drewsum/LTC7851_Demo/hdw/LTC7851_Demo/render1.png

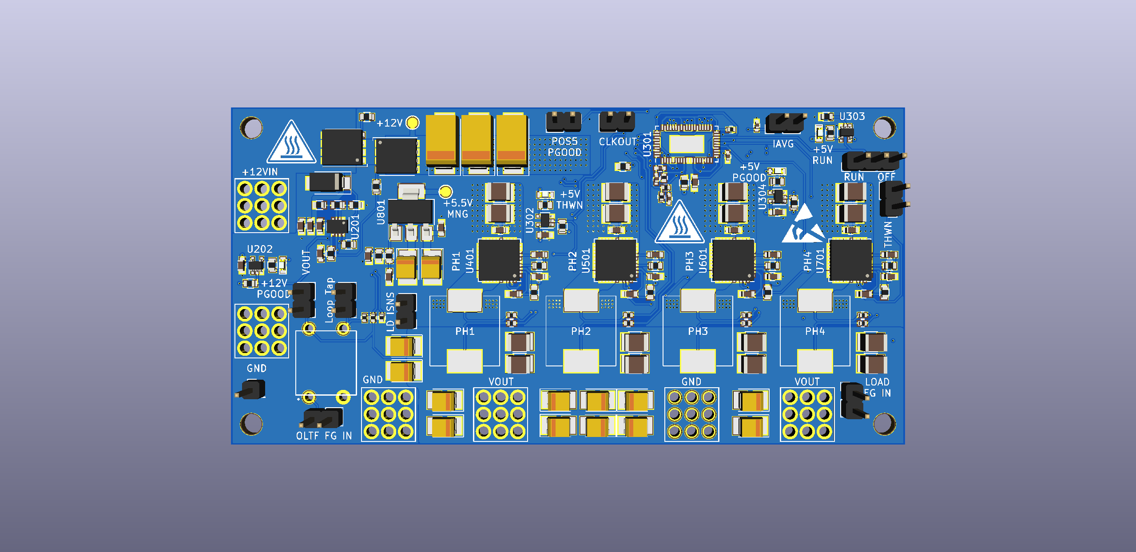
hdw/LTC7851_Demo/render1.png
