drewsum/LTC7851_Demo/hdw/LTC7851_Demo/render2.png

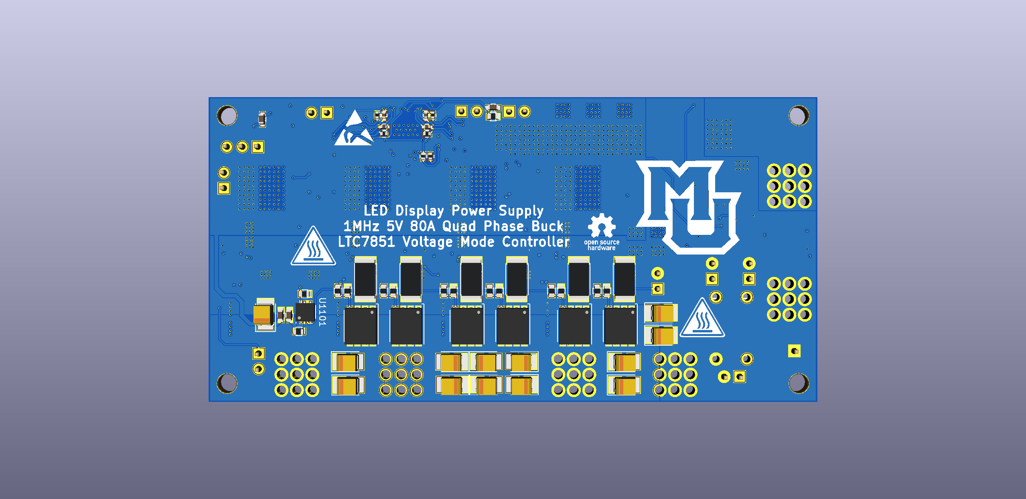
hdw/LTC7851_Demo/render2.png
