drewsum/LTC7851_Demo/README.md

# LTC7851_Demo
Demo board for testing LTC7851 Quad Phase Buck Converter
KiCAD V5.0.0
