drewsum/LTC7851_Demo/hdw/LTC7851_Demo/LTC7851_Demo.pdf

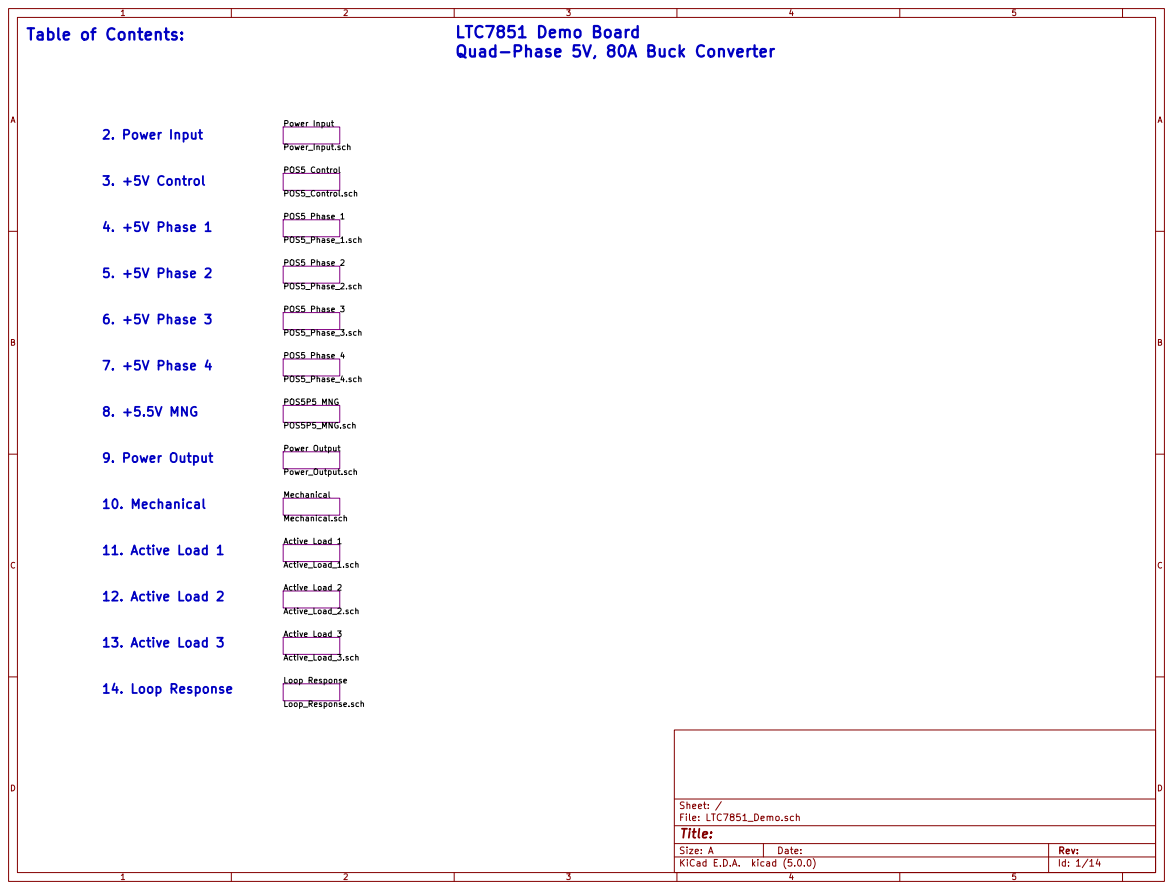
[picture p3: page 1]

Power_Input.sch POS5 Control POS5_Control.sch POS5 Phase 1 POS5_Phase_1.sch POS5 Phase 2 POS5_Phase_2.sch POS5 Phase 3 POS5_Phase_3.sch POS5 Phase 4 POS5_Phase_4.sch POS5P5 MNG

Quad-Phase 5V, 80A Buck Converter

7. +5V Phase 4
Power_Output.sch Mechanical Mechanical.sch Active Load 1 Active_Load_1.sch Active Load 2 Active_Load_2.sch Active Load 3 Active_Load_3.sch

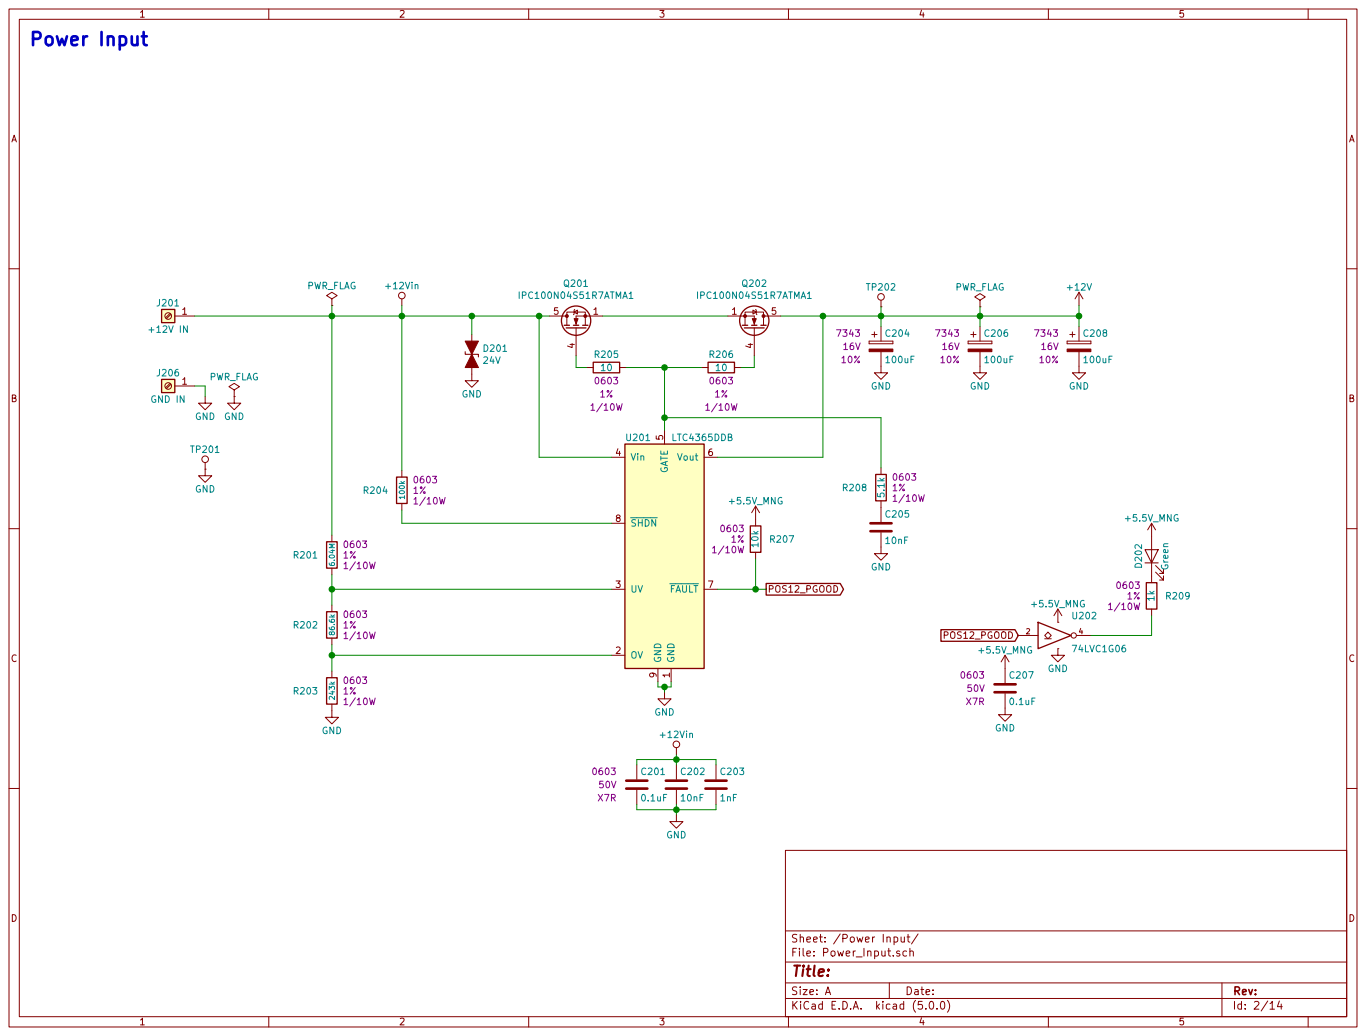
[picture p4: page 2]

5 Vout 6 FAULT 7 SHDN 8 GND

1 OV 2 UV 3 Vin 4 GATE

Sheet: /Power Input/ GND

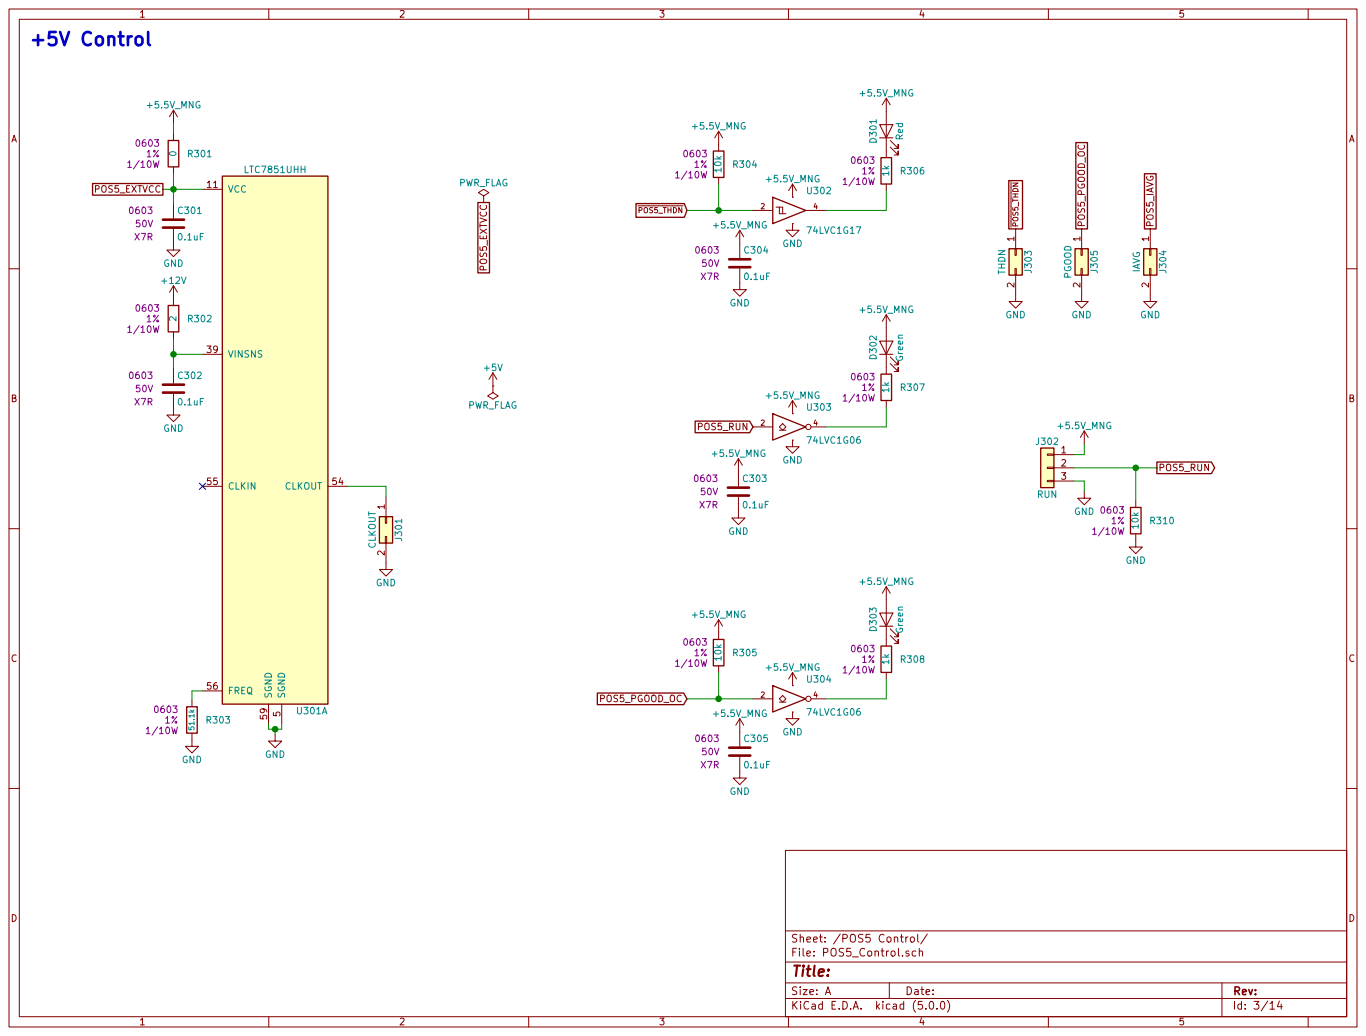
[picture p5: page 3]

5 CLKOUT 54 CLKIN 55 FREQ 56 SGND 59U301A

File: POS5_Control.sch Sheet: /POS5 Control/

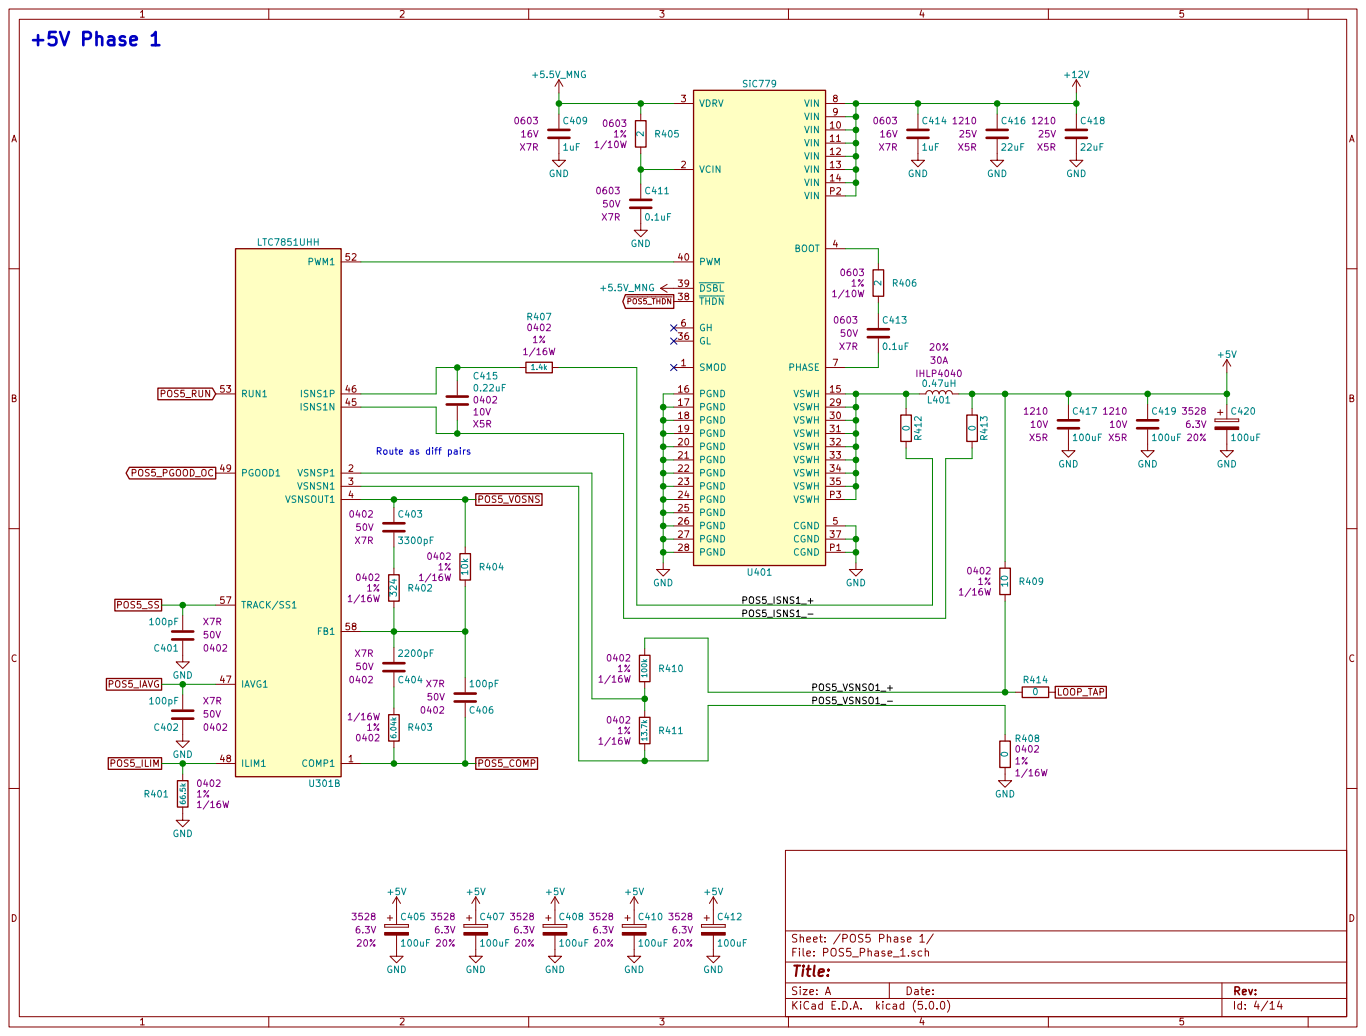
[picture p6: page 4]

POS5_ISNS1_+ POS5_ISNS1_- POS5_VSNSO1_- Route as diff pairs

File: POS5_Phase_1.sch Sheet: /POS5 Phase 1/

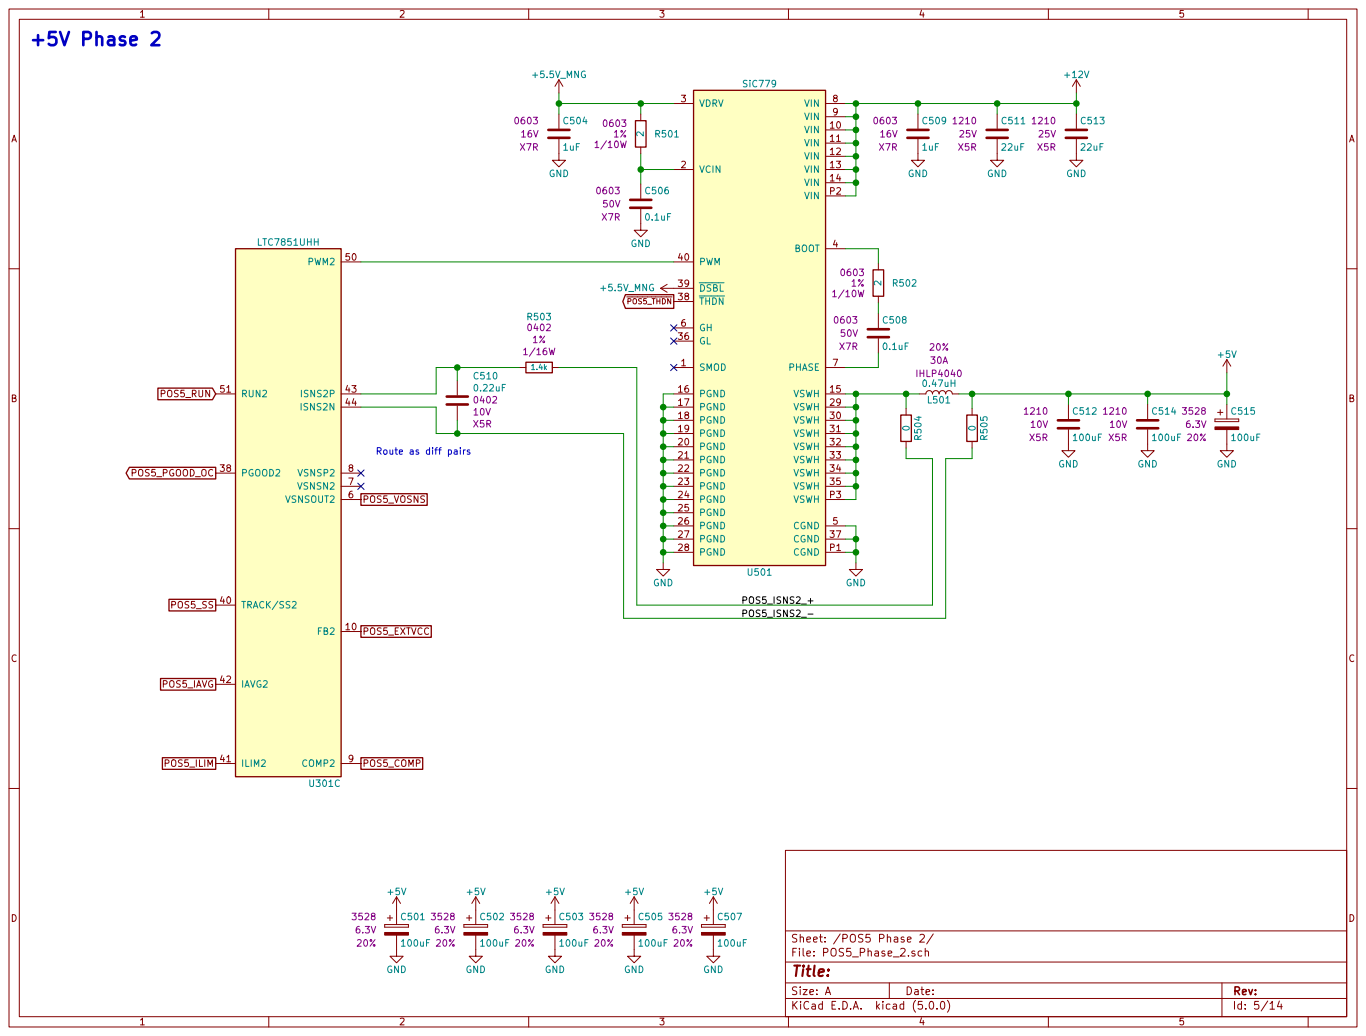
[picture p7: page 5]

File: POS5_Phase_2.sch Sheet: /POS5 Phase 2/

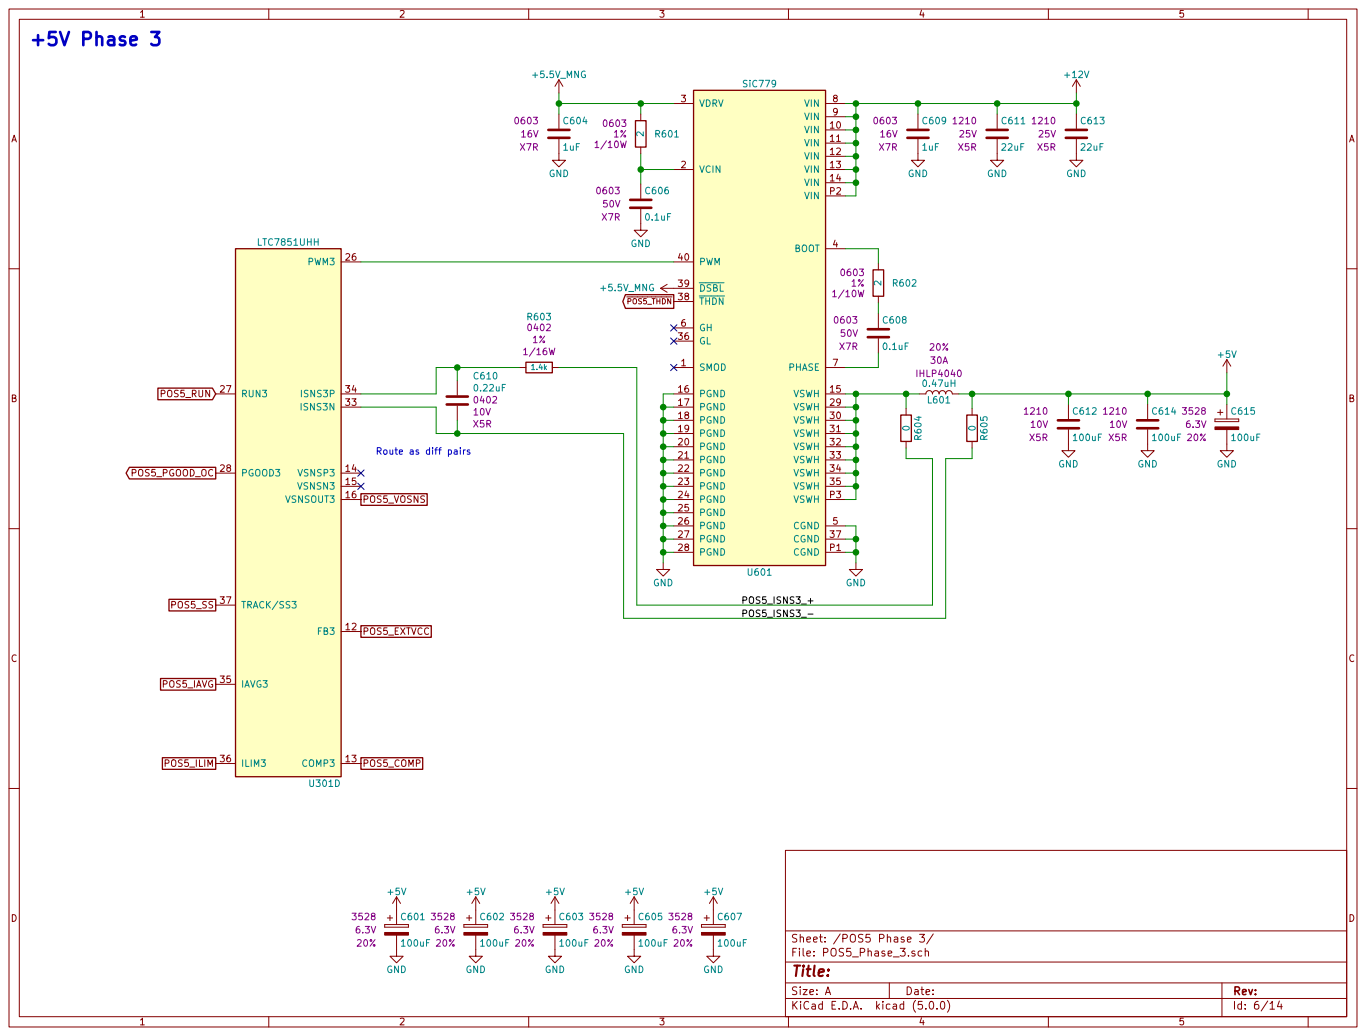
[picture p8: page 6]

File: POS5_Phase_3.sch Sheet: /POS5 Phase 3/

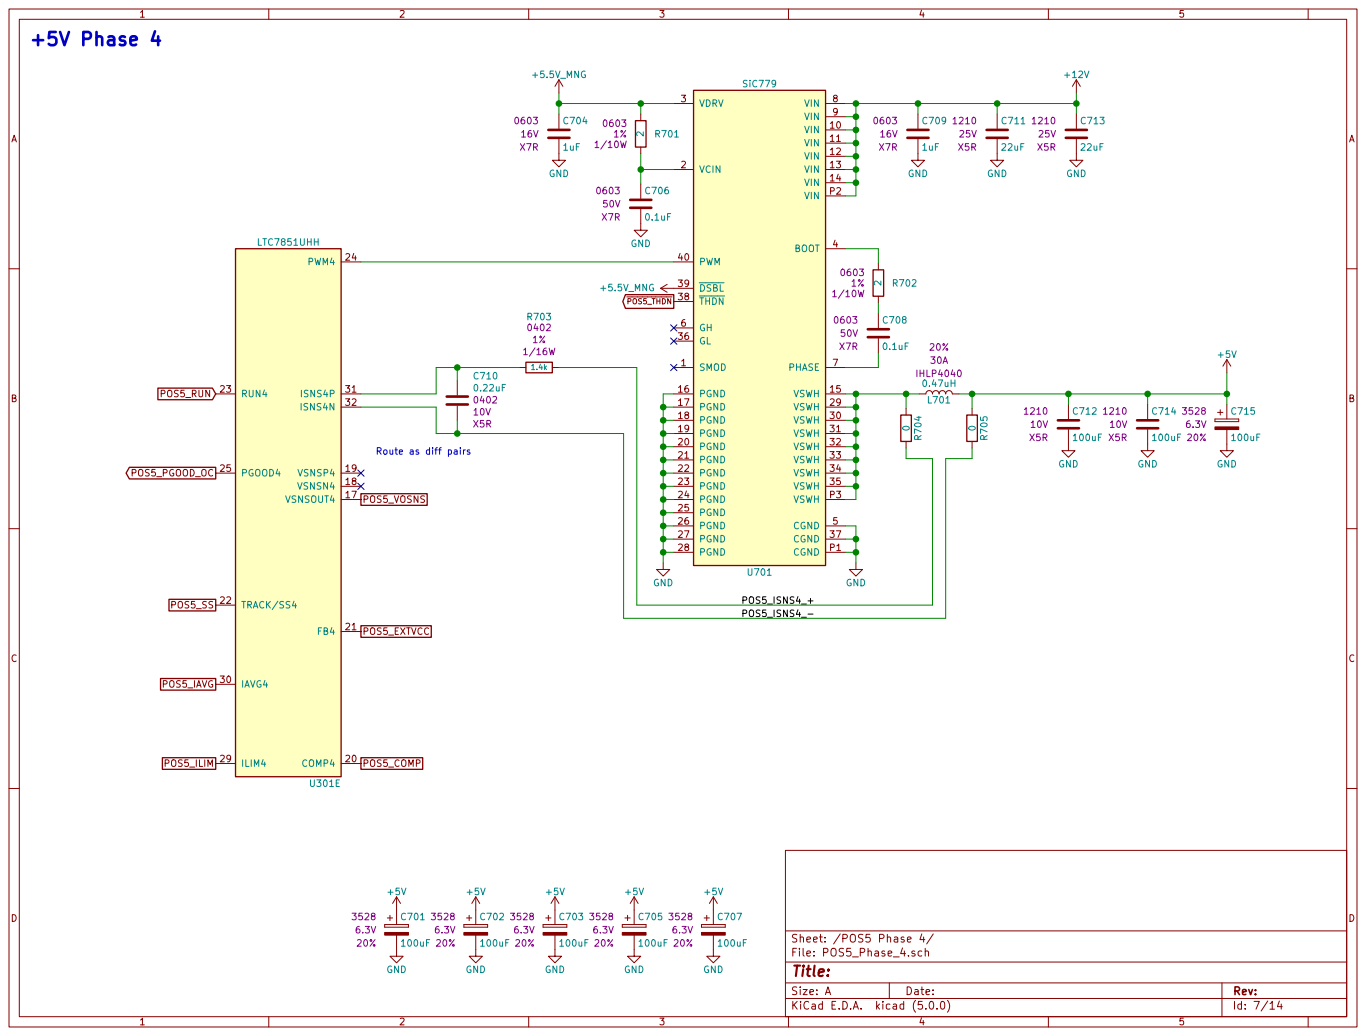
[picture p9: page 7]

File: POS5_Phase_4.sch Sheet: /POS5 Phase 4/

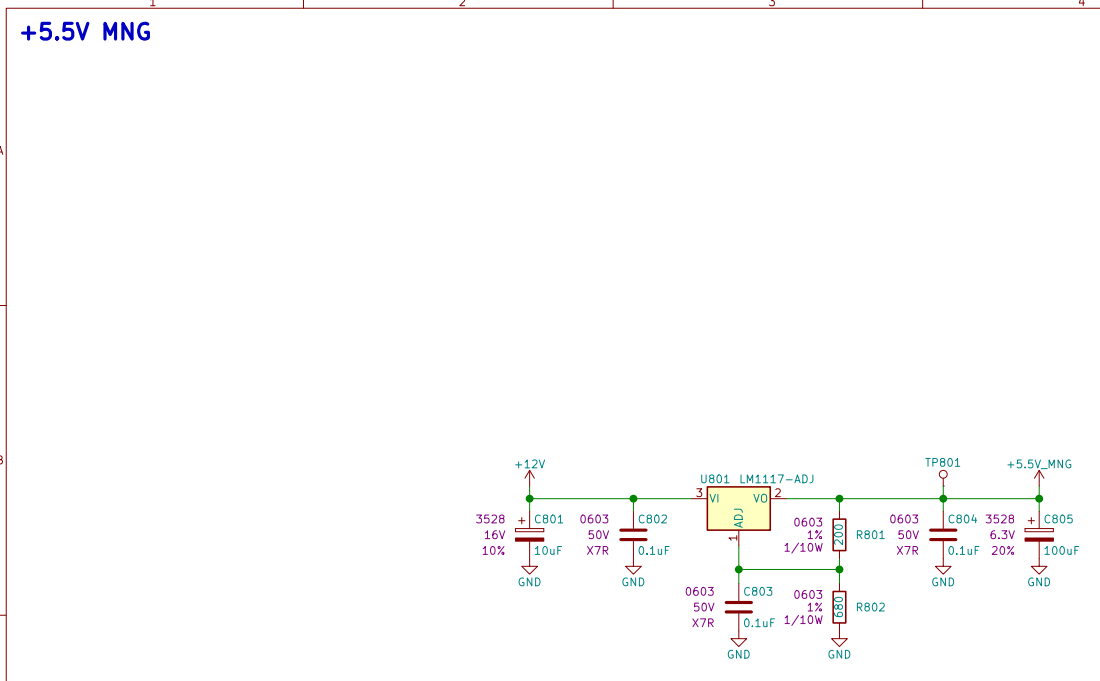
[picture p10: page 8]

File: POS5P5_MNG.sch Sheet: /POS5P5 MNG/

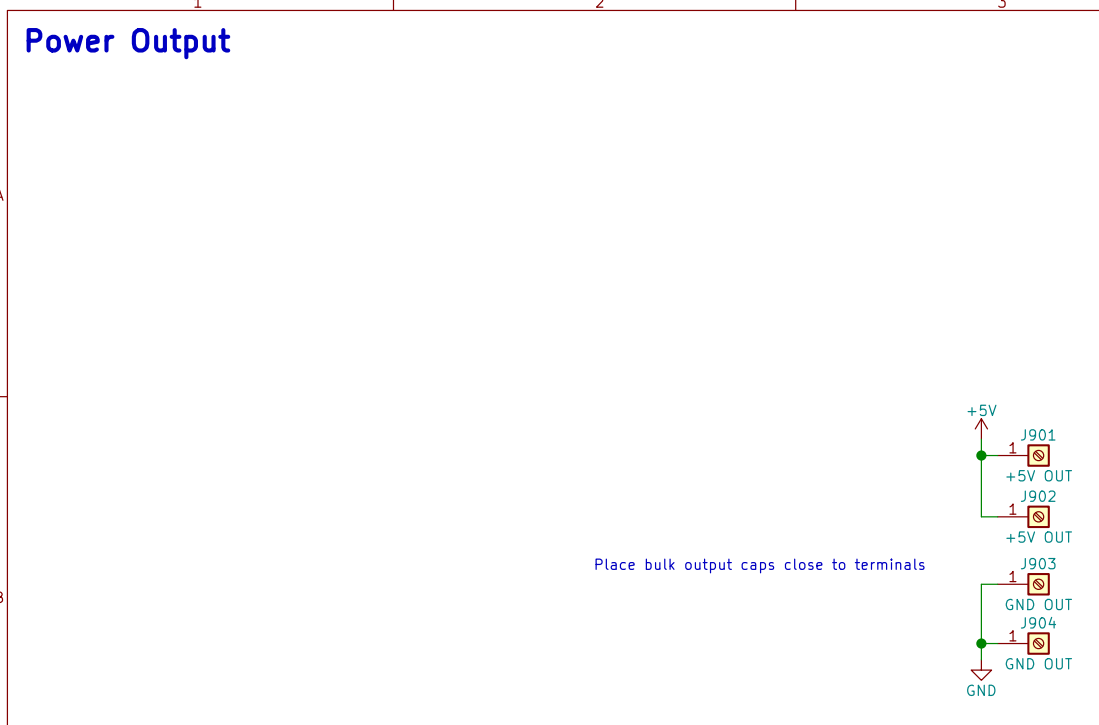
[picture p11: page 9]

Place bulk output caps close to terminals

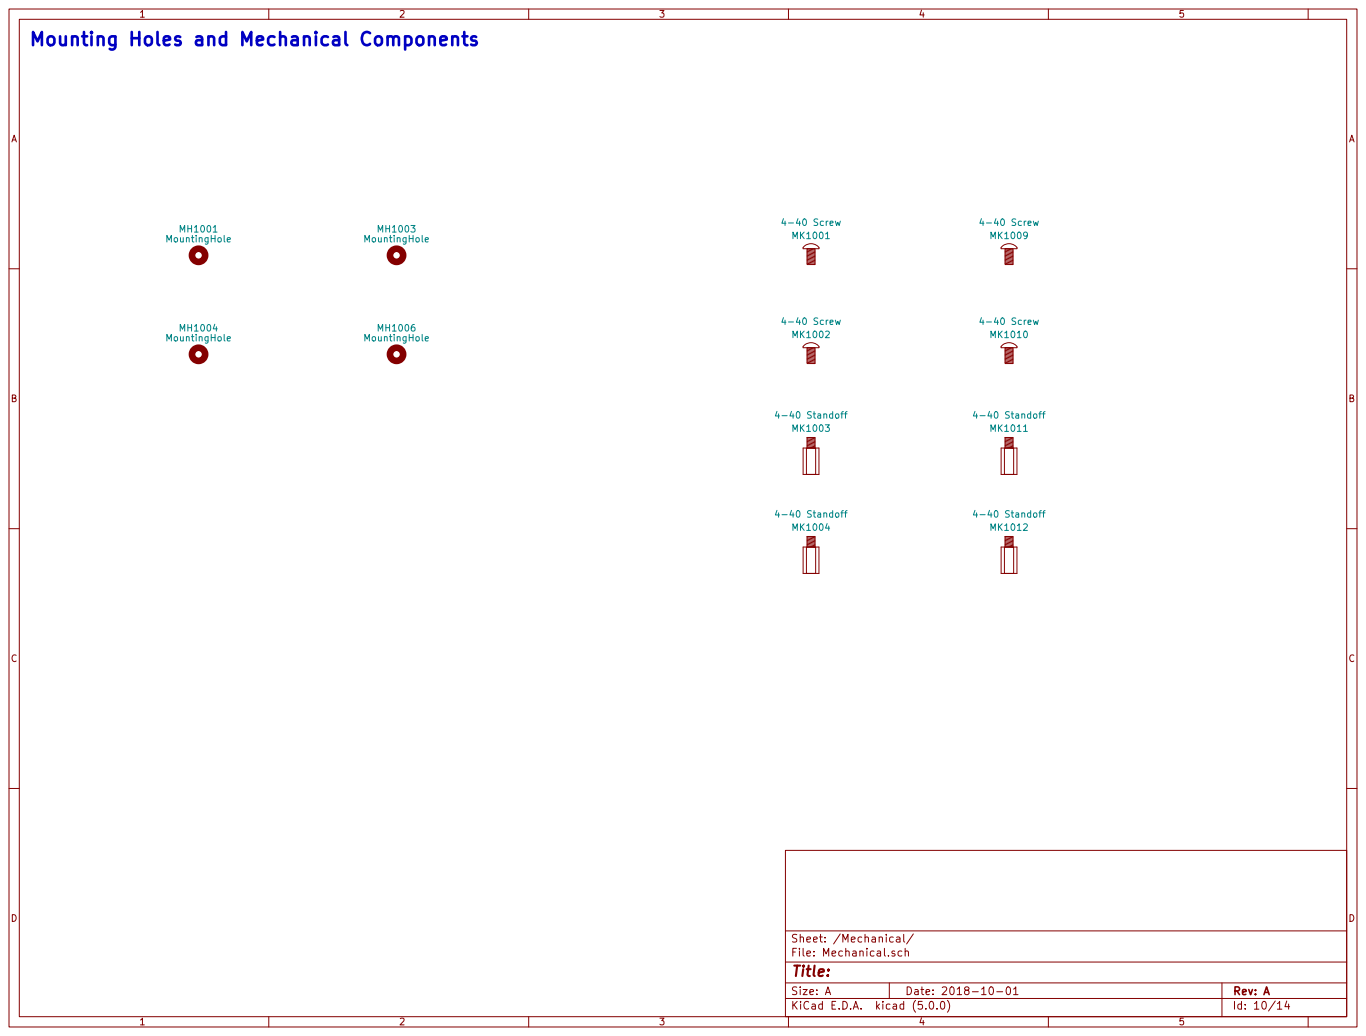
[picture p12: page 10]

Id: 10/14 Title: File: Mechanical.sch Sheet: /Mechanical/ Mounting Holes and Mechanical Components

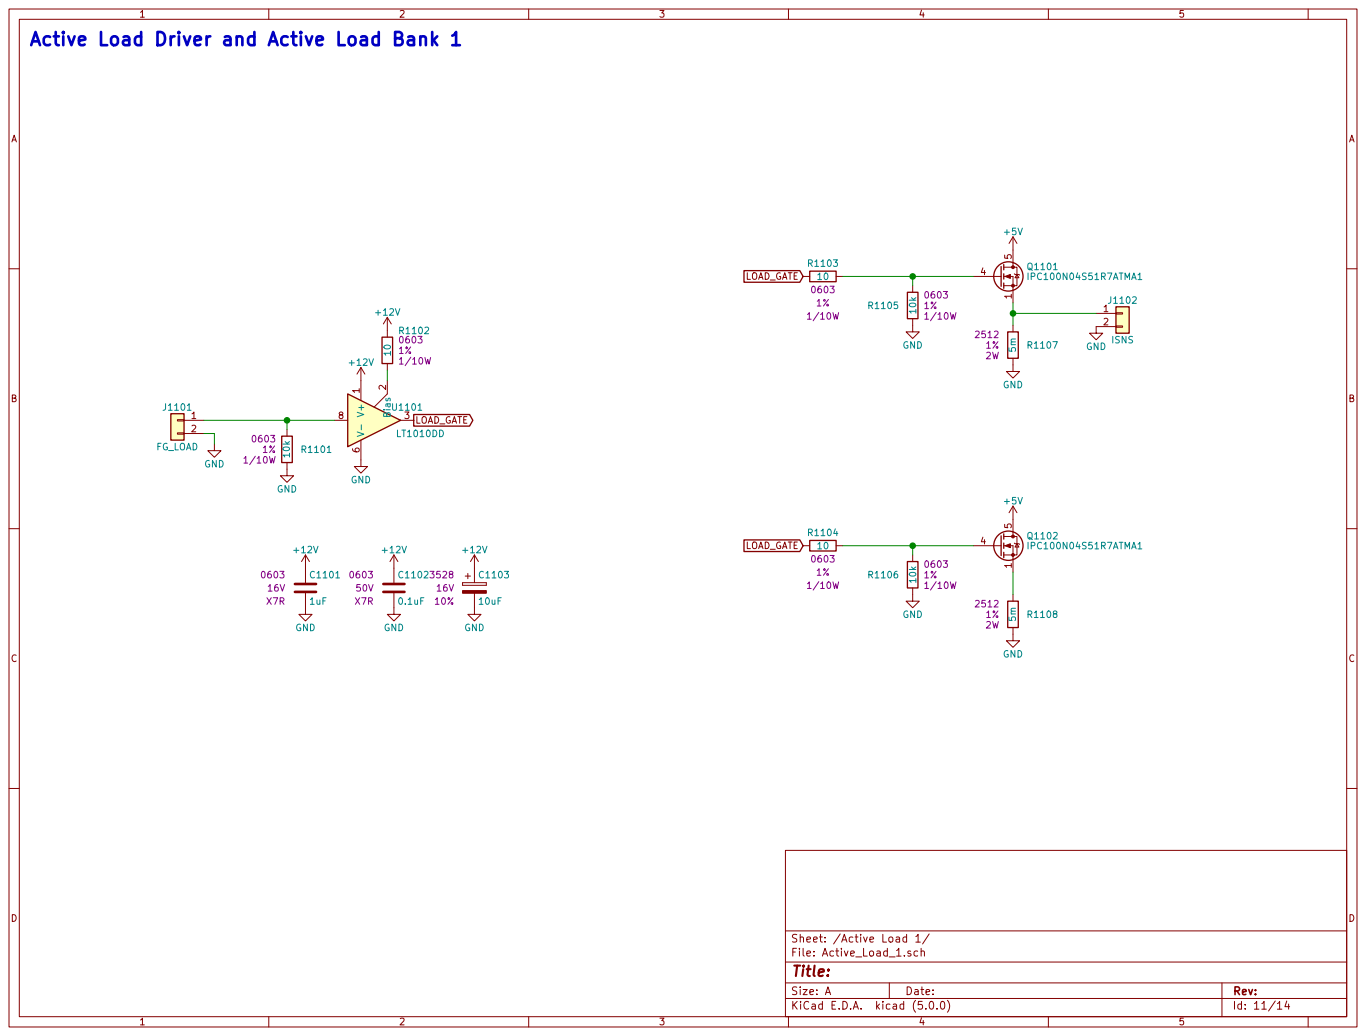
[picture p13: page 11]

+12V GND Active Load Driver and Active Load Bank 1

File: Active_Load_1.sch Sheet: /Active Load 1/

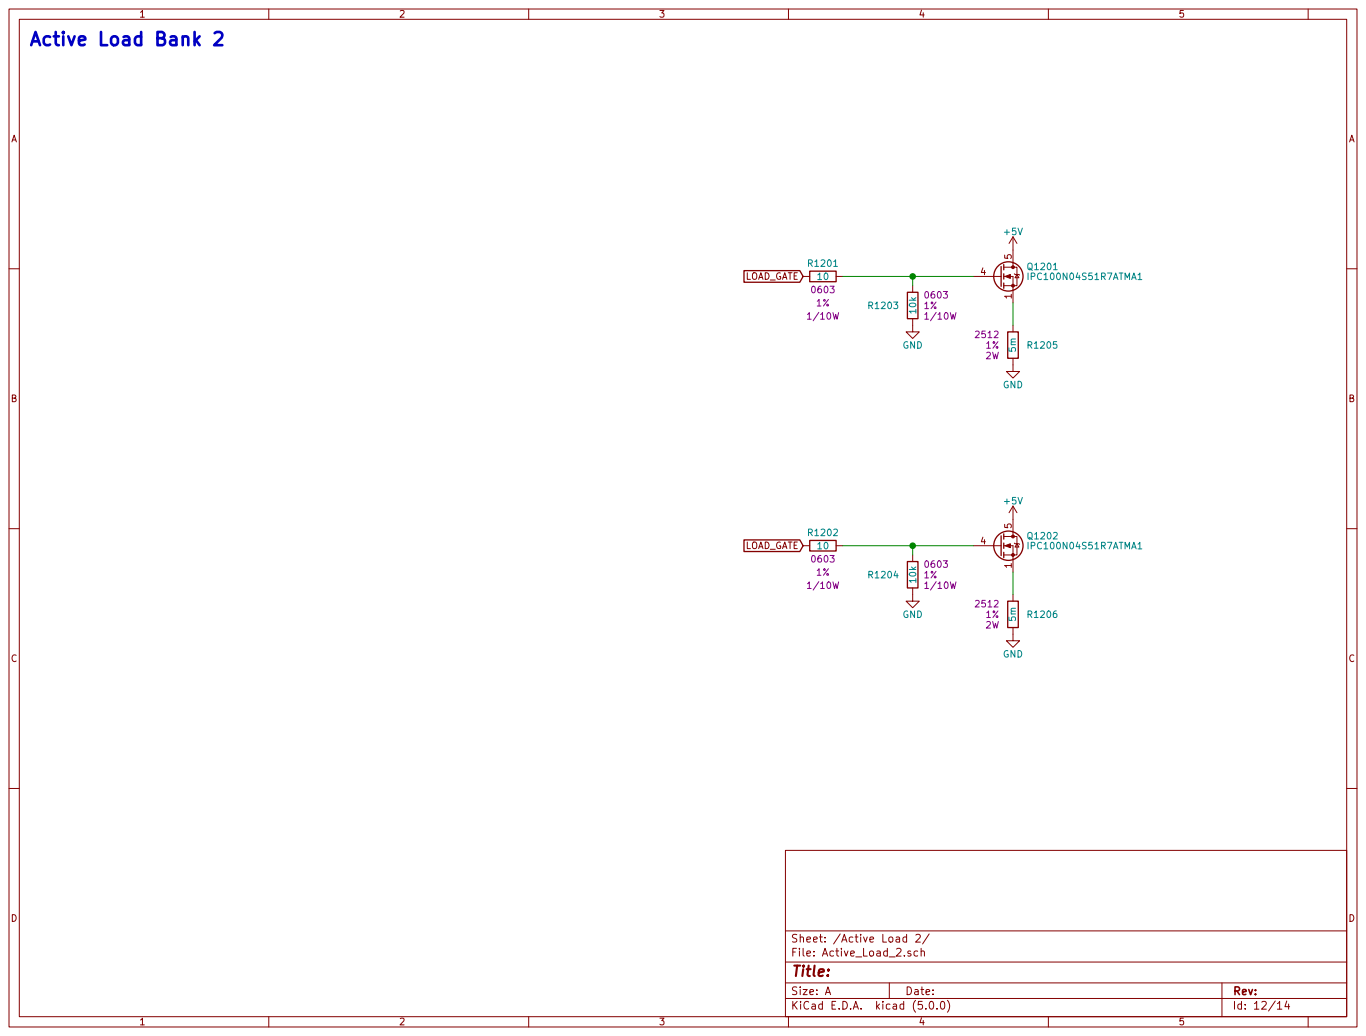
[picture p14: page 12]

File: Active_Load_2.sch Sheet: /Active Load 2/

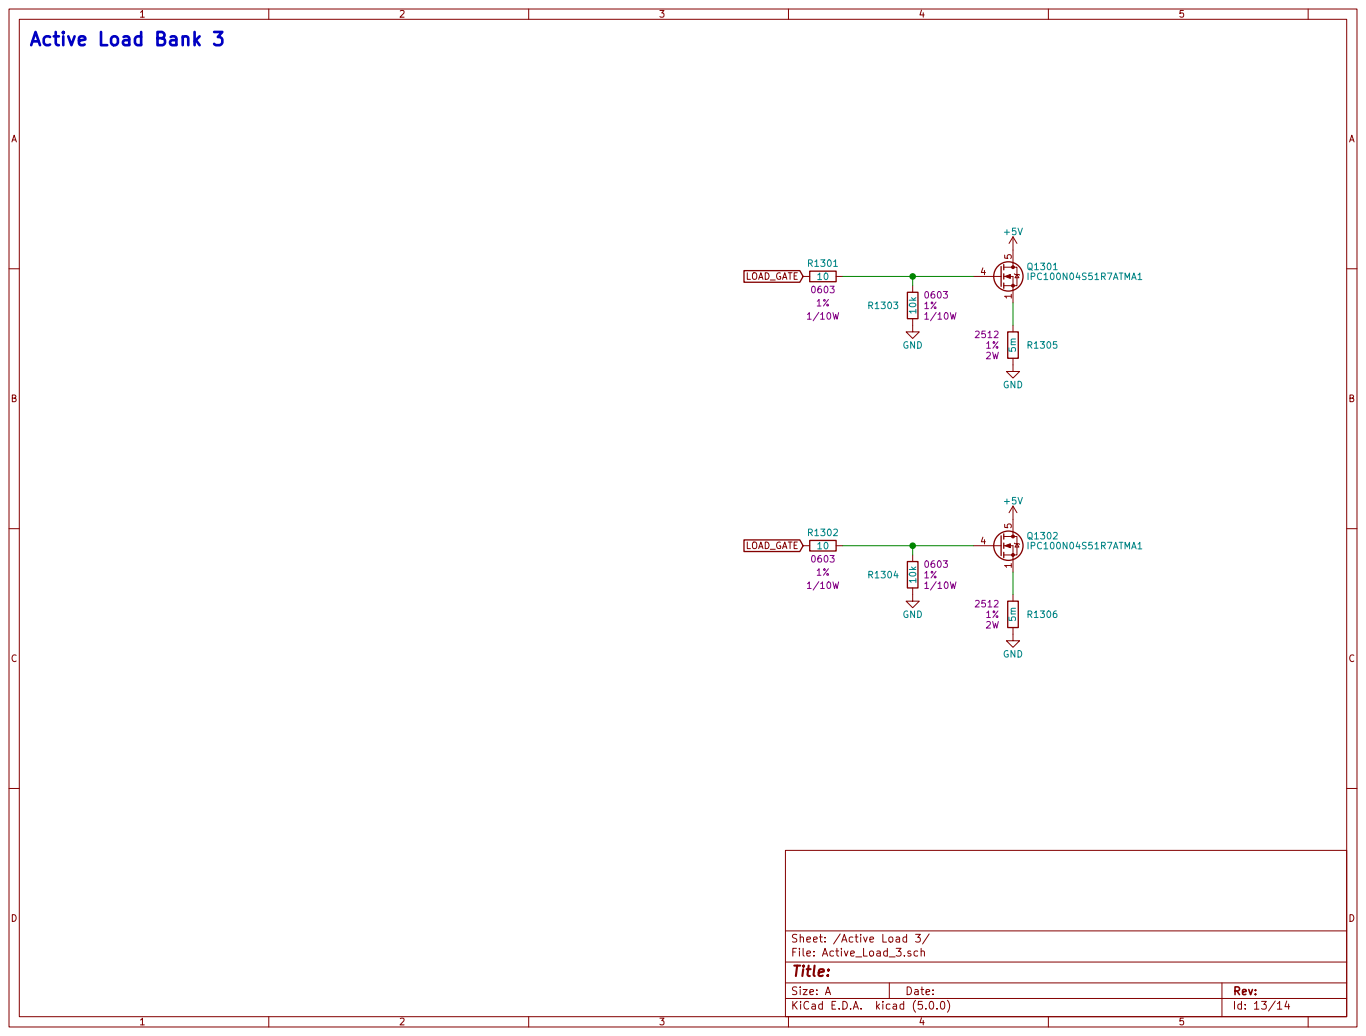
[picture p15: page 13]

File: Active_Load_3.sch Sheet: /Active Load 3/

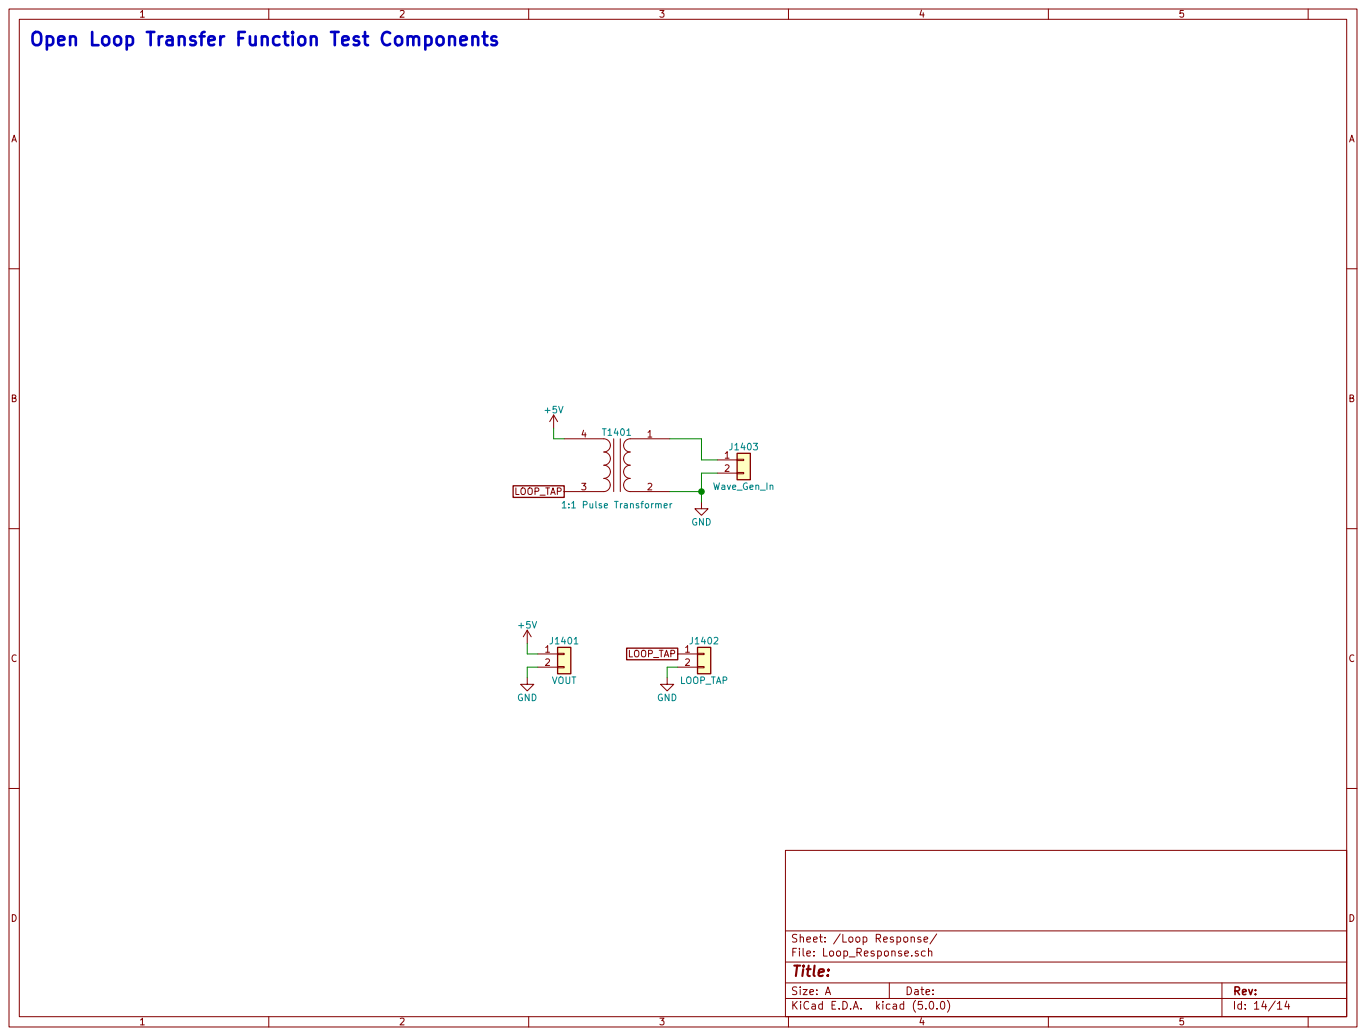
[picture p16: page 14]
