drewsum/LTC7851_Demo/hdw/LTC7851_Demo/LTC7851_Demo.kicad_pcb

## KiCad design hdw/LTC7851_Demo/LTC7851_Demo.kicad_pcb (2018-11-12)

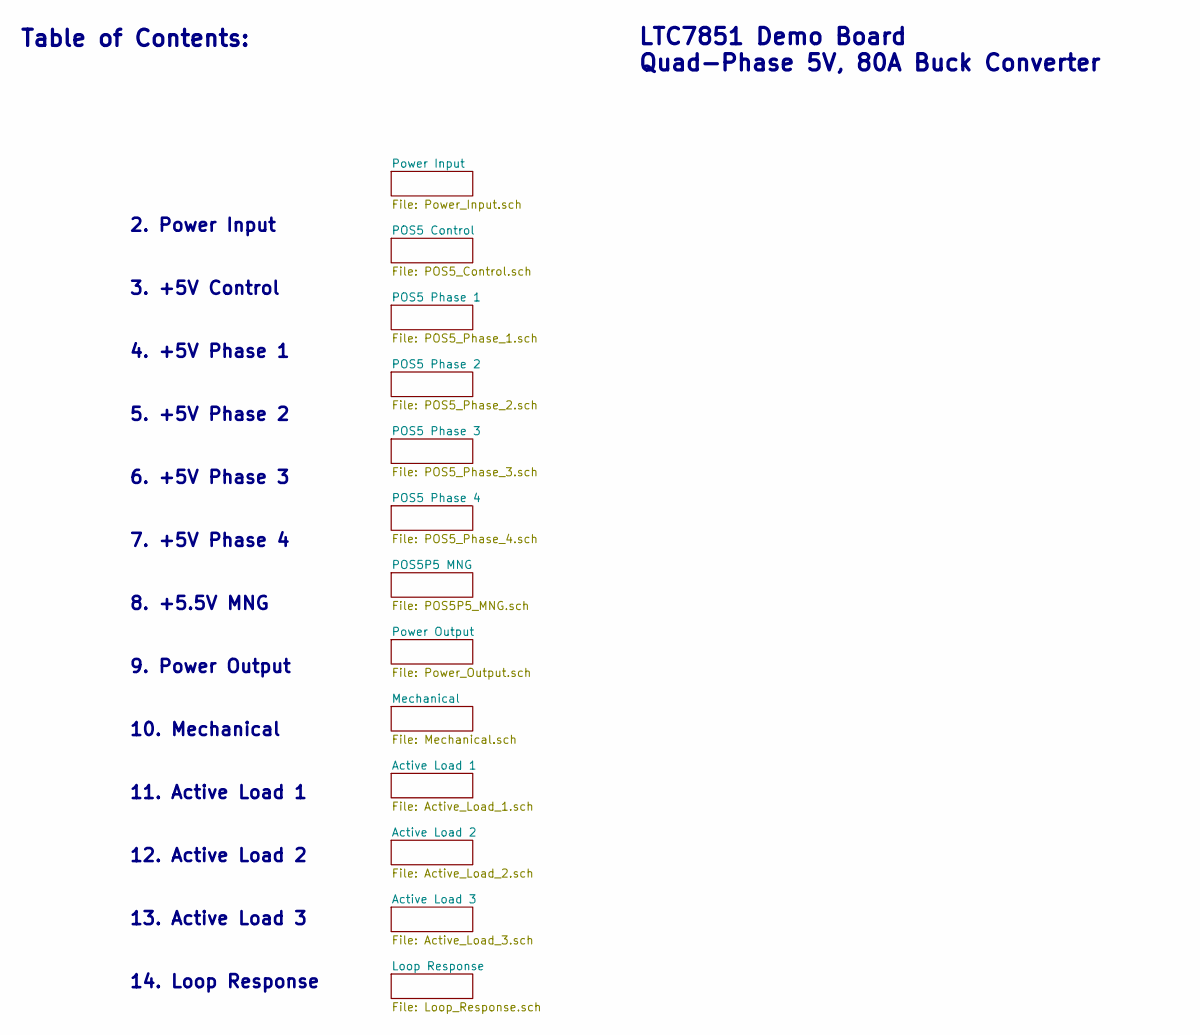
[picture p17: schematic LTC7851_Demo.sch]

Notes on the sheet:
Table of Contents:
LTC7851 Demo Board Quad-Phase 5V, 80A Buck Converter
2. Power Input 3. +5V Control 4. +5V Phase 1 5. +5V Phase 2 6. +5V Phase 3 7. +5V Phase 4 8. +5.5V MNG 9. Power Output 10. Mechanical 11. Active Load 1 12. Active Load 2 13. Active Load 3 14. Loop Response

Schematic: Power_Input.sch

Parts:
C201, C207: 0.1uF; C_0603; Voltage 50V; Digi-Key PN 490-4779-1-ND
C202, C205: 10nF; C_0603; Voltage 50V; Digi-Key PN 1276-1921-1-ND
C203: 1nF; C_0603; Voltage 50V; Digi-Key PN 311-1080-1-ND
C204, C206, C208: 100uF; CP_Tantalum_Case-X_EIA-7343-43_Reflow; Voltage 16V; Tolerance 10%; Digi-Key PN 718-1102-1-ND
D201: 24V; D_SMA; Digi-Key PN SMAJ24CALFCT-ND
D202: Green; LED_0603; Digi-Key PN 160-1446-1-ND
J201: +12V IN; Wuerth_7461096_M4_Shank_9pos; Digi-Key PN 732-3214-ND
J206: GND IN; Wuerth_7461096_M4_Shank_9pos; Digi-Key PN 732-3214-ND
Q201, Q202: IPC100N04S51R7ATMA1; TDSON-8-1; Digi-Key PN BSC123N10LSGATMA1CT-ND
R201: 6.04M; R_0603; Tolerance 1%; Digi-Key PN 541-6.04MHCT-ND
R202: 86.6k; R_0603; Tolerance 1%; Digi-Key PN 311-86.6KHRCT-ND
R203: 243k; R_0603; Tolerance 1%; Digi-Key PN 541-243KHCT-ND
R204: 100k; R_0603; Tolerance 1%; Digi-Key PN P100KHCT-ND
R205, R206: 10; R_0603; Tolerance 1%; Digi-Key PN YAG3351CT-ND
R207: 10k; R_0603; Tolerance 1%; Digi-Key PN RHM10KADCT-ND
R208: 5.1k; R_0603; Tolerance 1%; Digi-Key PN RMCF0603FT5K10CT-ND
R209: 1k; R_0603; Tolerance 1%; Digi-Key PN RHM1.0KDCT-ND
TP201: TP; Pin_Header_Angled_1x01_Pitch2.54mm
TP202: TP; Measurement_Point_Round-SMD-Pad_Small
U201: LTC4365DDB; DFN-8-1EP_2x3mm_Pitch0.5mm; Digi-Key PN LTC4365IDDB#TRMPBFCT-ND
U202: 74LVC1G06; SOT-353_SC-70-5; Digi-Key PN 296-8484-1-ND

Connections:
+5.5V_MNG: C207.1, D202.2, R207.1, U202.5; also elsewhere on the board
+12V: C204.1, C206.1, C208.1, Q202.5 (D), TP202.1, U201.6; also elsewhere on the board
+12Vin: C201.1, C202.1, C203.1, D201.1, J201.1, Q201.5 (D), R201.1, R204.1, U201.4
GND: C201.2, C202.2, C203.2, C204.2, C205.2, C206.2, C207.2, C208.2, D201.2, J206.1, R203.2, TP201.1, U201.1, U201.9, U202.3; also elsewhere on the board
unnamed: C205.1, R208.2
unnamed: D202.1, R209.1
unnamed: Q201.1 (S), Q201.2 (S), Q201.3 (S), Q202.1 (S), Q202.2 (S), Q202.3 (S)
unnamed: Q201.4 (G), R205.2
unnamed: Q202.4 (G), R206.1
unnamed: R201.2, R202.1, U201.3
unnamed: R202.2, R203.1, U201.2
unnamed: R204.2, U201.8
unnamed: R205.1, R206.2, R208.1, U201.5
unnamed: R209.2, U202.4
POS12_PGOOD: R207.2, U201.7, U202.2

Notes on the sheet:
Power Input

Schematic: POS5_Control.sch

Parts:
C301, C302, C303, C304, C305: 0.1uF; C_0603; Voltage 50V; Digi-Key PN 490-4779-1-ND
D301: Red; LED_0603; Digi-Key PN 160-1447-1-ND
D302, D303: Green; LED_0603; Digi-Key PN 160-1446-1-ND
J301: CLKOUT; Pin_Header_Straight_1x02_Pitch2.54mm
J302: RUN; Pin_Header_Straight_1x03_Pitch2.54mm
J303: THDN; Pin_Header_Straight_1x02_Pitch2.54mm
J304: IAVG; Pin_Header_Straight_1x02_Pitch2.54mm
J305: PGOOD; Pin_Header_Straight_1x02_Pitch2.54mm
R301: 0; R_0603; Tolerance 1%; Digi-Key PN 311-0.0GRCT-ND
R302: 2; R_0603; Tolerance 1%; Digi-Key PN RMCF0603FT2R00CT-ND
R303: 51.1k; R_0603; Tolerance 1%; Digi-Key PN P51.1KHCT-ND
R304, R305, R310: 10k; R_0603; Tolerance 1%; Digi-Key PN RHM10KADCT-ND
R306, R307, R308: 1k; R_0603; Tolerance 1%; Digi-Key PN RHM1.0KDCT-ND
U301: LTC7851UHH; QFN-58-1EP_9x5mm_Pitch0.4mm; Digi-Key PN LTC7851IUHH#PBF-ND
U302: 74LVC1G17; SOT-353_SC-70-5; Digi-Key PN 296-11934-1-ND
U303, U304: 74LVC1G06; SOT-353_SC-70-5; Digi-Key PN 296-8484-1-ND

Connections:
+5.5V_MNG: C303.1, C304.1, C305.1, D301.2, D302.2, D303.2, J302.1, R301.1, R304.1, R305.1, U302.5, U303.5, U304.5; also elsewhere on the board
+12V: R302.1; also elsewhere on the board
/POS5 Phase 1/POS5_ISNS1_-: U301.45; also elsewhere on the board
/POS5 Phase 1/POS5_VSNSO1_-: U301.3; also elsewhere on the board
/POS5 Phase 2/POS5_ISNS2_-: U301.44; also elsewhere on the board
/POS5 Phase 3/POS5_ISNS3_-: U301.33; also elsewhere on the board
/POS5 Phase 4/POS5_ISNS4_-: U301.32; also elsewhere on the board
GND: C301.2, C302.2, C303.2, C304.2, C305.2, J301.2, J302.3, J303.2, J304.2, J305.2, R303.2, R310.2, U301.5, U301.59, U302.3, U303.3, U304.3; also elsewhere on the board
unnamed: C302.1, R302.2, U301.39
unnamed 21: U301.58; also elsewhere on the board
unnamed 25: U301.46; also elsewhere on the board
unnamed 29: U301.43; also elsewhere on the board
unnamed 33: U301.34; also elsewhere on the board
unnamed 37: U301.31; also elsewhere on the board
unnamed: D301.1, R306.1
unnamed: D302.1, R307.1
unnamed: D303.1, R308.1
unnamed: J301.1, U301.54
unnamed: R303.1, U301.56
unnamed: R306.2, U302.4
unnamed: R307.2, U303.4
unnamed: R308.2, U304.4
unnamed 75: U301.2; also elsewhere on the board
unnamed 80: U301.24; also elsewhere on the board
unnamed 81: U301.26; also elsewhere on the board
unnamed 82: U301.50; also elsewhere on the board
unnamed 83: U301.52; also elsewhere on the board
POS5_COMP: U301.1, U301.9, U301.13, U301.20; also elsewhere on the board
POS5_EXTVCC: C301.1, R301.2, U301.10, U301.11, U301.12, U301.21
POS5_IAVG: J304.1, U301.30, U301.35, U301.42, U301.47; also elsewhere on the board
POS5_ILIM: U301.29, U301.36, U301.41, U301.48; also elsewhere on the board
POS5_PGOOD_OC: J305.1, R305.2, U301.25, U301.28, U301.38, U301.49, U304.2
POS5_RUN: J302.2, R310.1, U301.23, U301.27, U301.51, U301.53, U303.2
POS5_SS: U301.22, U301.37, U301.40, U301.57; also elsewhere on the board
POS5_VOSNS: U301.4, U301.6, U301.16, U301.17; also elsewhere on the board
~POS5_THDN: J303.1, R304.2, U302.2; also elsewhere on the board

Notes on the sheet:
+5V Control

Schematic: POS5_Phase_1.sch

Parts:
C401, C402, C406: 100pF; C_0402; Voltage 50V; Digi-Key PN 478-1089-1-ND
C403: 3300pF; C_0402; Voltage 50V; Digi-Key PN 478-5132-1-ND
C404: 2200pF; C_0402; Voltage 50V; Digi-Key PN 478-1105-1-ND
C405, C407, C408, C410, C412, C420: 100uF; CP_Tantalum_Case-B_EIA-3528-21_Reflow; Voltage 6.3V; Tolerance 20%; Digi-Key PN 478-9994-1-ND
C409, C414: 1uF; C_0603; Voltage 16V; Digi-Key PN 1276-6524-1-ND
C411, C413: 0.1uF; C_0603; Voltage 50V; Digi-Key PN 490-4779-1-ND
C415: 0.22uF; C_0402; Voltage 10V; Digi-Key PN 1276-1049-1-ND
C416, C418: 22uF; C_1210; Voltage 25V; Digi-Key PN 445-1436-1-ND
C417, C419: 100uF; C_1210; Voltage 10V; Digi-Key PN 587-3432-1-ND
L401: 0.47uH; L_Vishay_IHLP-4040; Tolerance 20%; Digi-Key PN 541-2595-1-ND
R401: 66.5k; R_0402; Tolerance 1%; Digi-Key PN RMCF0402FT66K5CT-ND
R402: 324; R_0402; Tolerance 1%; Digi-Key PN YAG3118CT-ND
R403: 6.04k; R_0402; Tolerance 1%; Digi-Key PN RMCF0402FT6K04CT-ND
R404: 10k; R_0402; Tolerance 1%; Digi-Key PN 311-10.0KLRCT-ND
R405, R406: 2; R_0603; Tolerance 1%; Digi-Key PN RMCF0603FT2R00CT-ND
R407: 1.4k; R_0402; Tolerance 1%; Digi-Key PN RMCF0402FT1K40CT-ND
R408, R412, R413, R414: 0; R_0402; Tolerance 1%; Digi-Key PN RMCF0402ZT0R00CT-ND
R409: 10; R_0402; Tolerance 1%; Digi-Key PN 311-10.0LRCT-ND
R410: 100k; R_0402; Tolerance 1%; Digi-Key PN 311-100KLRCT-ND
R411: 13.7k; R_0402; Tolerance 1%; Digi-Key PN 311-13.7KLRCT-ND
U301: LTC7851UHH; QFN-58-1EP_9x5mm_Pitch0.4mm; Digi-Key PN LTC7851IUHH#PBF-ND
U401: SiC779; MLP66-40_6x6mm_Pitch0.5mm; Digi-Key PN SIC779CD-T1-GE3CT-ND

Connections:
+5.5V_MNG: C409.1, R405.1, U401.3, U401.39; also elsewhere on the board
+5V: C405.1, C407.1, C408.1, C410.1, C412.1, C417.1, C419.1, C420.1, L401.2, R409.1, R413.2; also elsewhere on the board
+12V: C414.1, C416.1, C418.1, U401.8, U401.9, U401.10, U401.11, U401.12, U401.13, U401.14, U401.P2; also elsewhere on the board
/POS5 Phase 1/POS5_ISNS1_+: R407.1, R412.1
/POS5 Phase 1/POS5_ISNS1_-: C415.1, R413.1, U301.45
/POS5 Phase 1/POS5_VSNSO1_+: R409.2, R410.1, R414.2
/POS5 Phase 1/POS5_VSNSO1_-: R408.1, R411.2, U301.3
/POS5 Phase 2/POS5_ISNS2_-: U301.44; also elsewhere on the board
/POS5 Phase 3/POS5_ISNS3_-: U301.33; also elsewhere on the board
/POS5 Phase 4/POS5_ISNS4_-: U301.32; also elsewhere on the board
GND: C401.1, C402.1, C405.2, C407.2, C408.2, C409.2, C410.2, C411.2, C412.2, C414.2, C416.2, C417.2, C418.2, C419.2, C420.2, R401.2, R408.2, U301.5, U301.59, U401.5, U401.16, U401.17, U401.18, U401.19, U401.20, U401.21, U401.22, U401.23, U401.24, U401.25, U401.26, U401.27, U401.28, U401.37, U401.P1; also elsewhere on the board
LOOP_TAP: R414.1; also elsewhere on the board
unnamed 18: U301.39; also elsewhere on the board
unnamed: C403.2, R402.1
unnamed: C404.1, R403.2
unnamed: C404.2, C406.2, R402.2, R404.2, U301.58
unnamed: C411.1, R405.2, U401.2
unnamed: C413.1, R406.2
unnamed: C413.2, U401.7
unnamed: C415.2, R407.2, U301.46
unnamed 29: U301.43; also elsewhere on the board
unnamed 33: U301.34; also elsewhere on the board
unnamed 37: U301.31; also elsewhere on the board
unnamed 43: U301.54; also elsewhere on the board
unnamed: L401.1, R412.2, U401.15, U401.29, U401.30, U401.31, U401.32, U401.33, U401.34, U401.35, U401.P3
unnamed 70: U301.56; also elsewhere on the board
unnamed: R406.1, U401.4
unnamed: R410.2, R411.1, U301.2
unnamed 80: U301.24; also elsewhere on the board
unnamed 81: U301.26; also elsewhere on the board
unnamed 82: U301.50; also elsewhere on the board
unnamed: U301.52, U401.40
POS5_COMP: C406.1, R403.1, U301.1, U301.9, U301.13, U301.20
POS5_EXTVCC: U301.10, U301.11, U301.12, U301.21; also elsewhere on the board
POS5_IAVG: C402.2, U301.30, U301.35, U301.42, U301.47; also elsewhere on the board
POS5_ILIM: R401.1, U301.29, U301.36, U301.41, U301.48
POS5_PGOOD_OC: U301.25, U301.28, U301.38, U301.49; also elsewhere on the board
POS5_RUN: U301.23, U301.27, U301.51, U301.53; also elsewhere on the board
POS5_SS: C401.2, U301.22, U301.37, U301.40, U301.57
POS5_VOSNS: C403.1, R404.1, U301.4, U301.6, U301.16, U301.17
~POS5_THDN: U401.38; also elsewhere on the board

Notes on the sheet:
Route as diff pairs
+5V Phase 1

Schematic: POS5_Phase_2.sch

Parts:
C501, C502, C503, C505, C507, C515: 100uF; CP_Tantalum_Case-B_EIA-3528-21_Reflow; Voltage 6.3V; Tolerance 20%; Digi-Key PN 478-9994-1-ND
C504: 1uF; C_0603_HandSoldering; Voltage 16V; Digi-Key PN 1276-6524-1-ND
C506, C508: 0.1uF; C_0603; Voltage 50V; Digi-Key PN 490-4779-1-ND
C509: 1uF; C_0603; Voltage 16V; Digi-Key PN 1276-6524-1-ND
C510: 0.22uF; C_0402; Voltage 10V; Digi-Key PN 1276-1049-1-ND
C511, C513: 22uF; C_1210; Voltage 25V; Digi-Key PN 445-1436-1-ND
C512, C514: 100uF; C_1210; Voltage 10V; Digi-Key PN 587-3432-1-ND
L501: 0.47uH; L_Vishay_IHLP-4040; Tolerance 20%; Digi-Key PN 541-2595-1-ND
R501, R502: 2; R_0603; Tolerance 1%; Digi-Key PN RMCF0603FT2R00CT-ND
R503: 1.4k; R_0402; Tolerance 1%; Digi-Key PN RMCF0402FT1K40CT-ND
R504, R505: 0; R_0402; Tolerance 1%; Digi-Key PN RMCF0402ZT0R00CT-ND
U301: LTC7851UHH; QFN-58-1EP_9x5mm_Pitch0.4mm; Digi-Key PN LTC7851IUHH#PBF-ND
U501: SiC779; MLP66-40_6x6mm_Pitch0.5mm; Digi-Key PN SIC779CD-T1-GE3CT-ND

Connections:
+5.5V_MNG: C504.1, R501.1, U501.3, U501.39; also elsewhere on the board
+5V: C501.1, C502.1, C503.1, C505.1, C507.1, C512.1, C514.1, C515.1, L501.2, R505.2; also elsewhere on the board
+12V: C509.1, C511.1, C513.1, U501.8, U501.9, U501.10, U501.11, U501.12, U501.13, U501.14, U501.P2; also elsewhere on the board
/POS5 Phase 1/POS5_ISNS1_-: U301.45; also elsewhere on the board
/POS5 Phase 1/POS5_VSNSO1_-: U301.3; also elsewhere on the board
/POS5 Phase 2/POS5_ISNS2_+: R503.1, R504.1
/POS5 Phase 2/POS5_ISNS2_-: C510.1, R505.1, U301.44
/POS5 Phase 3/POS5_ISNS3_-: U301.33; also elsewhere on the board
/POS5 Phase 4/POS5_ISNS4_-: U301.32; also elsewhere on the board
GND: C501.2, C502.2, C503.2, C504.2, C505.2, C506.2, C507.2, C509.2, C511.2, C512.2, C513.2, C514.2, C515.2, U301.5, U301.59, U501.5, U501.16, U501.17, U501.18, U501.19, U501.20, U501.21, U501.22, U501.23, U501.24, U501.25, U501.26, U501.27, U501.28, U501.37, U501.P1; also elsewhere on the board
unnamed 18: U301.39; also elsewhere on the board
unnamed 21: U301.58; also elsewhere on the board
unnamed 25: U301.46; also elsewhere on the board
unnamed: C506.1, R501.2, U501.2
unnamed: C508.1, R502.2
unnamed: C508.2, U501.7
unnamed: C510.2, R503.2, U301.43
unnamed 33: U301.34; also elsewhere on the board
unnamed 37: U301.31; also elsewhere on the board
unnamed 43: U301.54; also elsewhere on the board
unnamed: L501.1, R504.2, U501.15, U501.29, U501.30, U501.31, U501.32, U501.33, U501.34, U501.35, U501.P3
unnamed 70: U301.56; also elsewhere on the board
unnamed 75: U301.2; also elsewhere on the board
unnamed: R502.1, U501.4
unnamed 80: U301.24; also elsewhere on the board
unnamed 81: U301.26; also elsewhere on the board
unnamed: U301.50, U501.40
unnamed 83: U301.52; also elsewhere on the board
POS5_COMP: U301.1, U301.9, U301.13, U301.20; also elsewhere on the board
POS5_EXTVCC: U301.10, U301.11, U301.12, U301.21; also elsewhere on the board
POS5_IAVG: U301.30, U301.35, U301.42, U301.47; also elsewhere on the board
POS5_ILIM: U301.29, U301.36, U301.41, U301.48; also elsewhere on the board
POS5_PGOOD_OC: U301.25, U301.28, U301.38, U301.49; also elsewhere on the board
POS5_RUN: U301.23, U301.27, U301.51, U301.53; also elsewhere on the board
POS5_SS: U301.22, U301.37, U301.40, U301.57; also elsewhere on the board
POS5_VOSNS: U301.4, U301.6, U301.16, U301.17; also elsewhere on the board
~POS5_THDN: U501.38; also elsewhere on the board

Notes on the sheet:
+5V Phase 2
Route as diff pairs

Schematic: POS5_Phase_3.sch

Parts:
C601, C602, C603, C605, C607, C615: 100uF; CP_Tantalum_Case-B_EIA-3528-21_Reflow; Voltage 6.3V; Tolerance 20%; Digi-Key PN 478-9994-1-ND
C604, C609: 1uF; C_0603; Voltage 16V; Digi-Key PN 1276-6524-1-ND
C606, C608: 0.1uF; C_0603; Voltage 50V; Digi-Key PN 490-4779-1-ND
C610: 0.22uF; C_0402; Voltage 10V; Digi-Key PN 1276-1049-1-ND
C611, C613: 22uF; C_1210; Voltage 25V; Digi-Key PN 445-1436-1-ND
C612, C614: 100uF; C_1210; Voltage 10V; Digi-Key PN 587-3432-1-ND
L601: 0.47uH; L_Vishay_IHLP-4040; Tolerance 20%; Digi-Key PN 541-2595-1-ND
R601, R602: 2; R_0603; Tolerance 1%; Digi-Key PN RMCF0603FT2R00CT-ND
R603: 1.4k; R_0402; Tolerance 1%; Digi-Key PN RMCF0402FT1K40CT-ND
R604, R605: 0; R_0402; Tolerance 1%; Digi-Key PN RMCF0402ZT0R00CT-ND
U301: LTC7851UHH; QFN-58-1EP_9x5mm_Pitch0.4mm; Digi-Key PN LTC7851IUHH#PBF-ND
U601: SiC779; MLP66-40_6x6mm_Pitch0.5mm; Digi-Key PN SIC779CD-T1-GE3CT-ND

Connections:
+5.5V_MNG: C604.1, R601.1, U601.3, U601.39; also elsewhere on the board
+5V: C601.1, C602.1, C603.1, C605.1, C607.1, C612.1, C614.1, C615.1, L601.2, R605.2; also elsewhere on the board
+12V: C609.1, C611.1, C613.1, U601.8, U601.9, U601.10, U601.11, U601.12, U601.13, U601.14, U601.P2; also elsewhere on the board
/POS5 Phase 1/POS5_ISNS1_-: U301.45; also elsewhere on the board
/POS5 Phase 1/POS5_VSNSO1_-: U301.3; also elsewhere on the board
/POS5 Phase 2/POS5_ISNS2_-: U301.44; also elsewhere on the board
/POS5 Phase 3/POS5_ISNS3_+: R603.1, R604.1
/POS5 Phase 3/POS5_ISNS3_-: C610.1, R605.1, U301.33
/POS5 Phase 4/POS5_ISNS4_-: U301.32; also elsewhere on the board
GND: C601.2, C602.2, C603.2, C604.2, C605.2, C606.2, C607.2, C609.2, C611.2, C612.2, C613.2, C614.2, C615.2, U301.5, U301.59, U601.5, U601.16, U601.17, U601.18, U601.19, U601.20, U601.21, U601.22, U601.23, U601.24, U601.25, U601.26, U601.27, U601.28, U601.37, U601.P1; also elsewhere on the board
unnamed 18: U301.39; also elsewhere on the board
unnamed 21: U301.58; also elsewhere on the board
unnamed 25: U301.46; also elsewhere on the board
unnamed 29: U301.43; also elsewhere on the board
unnamed: C606.1, R601.2, U601.2
unnamed: C608.1, R602.2
unnamed: C608.2, U601.7
unnamed: C610.2, R603.2, U301.34
unnamed 37: U301.31; also elsewhere on the board
unnamed 43: U301.54; also elsewhere on the board
unnamed: L601.1, R604.2, U601.15, U601.29, U601.30, U601.31, U601.32, U601.33, U601.34, U601.35, U601.P3
unnamed 70: U301.56; also elsewhere on the board
unnamed 75: U301.2; also elsewhere on the board
unnamed: R602.1, U601.4
unnamed 80: U301.24; also elsewhere on the board
unnamed: U301.26, U601.40
unnamed 82: U301.50; also elsewhere on the board
unnamed 83: U301.52; also elsewhere on the board
POS5_COMP: U301.1, U301.9, U301.13, U301.20; also elsewhere on the board
POS5_EXTVCC: U301.10, U301.11, U301.12, U301.21; also elsewhere on the board
POS5_IAVG: U301.30, U301.35, U301.42, U301.47; also elsewhere on the board
POS5_ILIM: U301.29, U301.36, U301.41, U301.48; also elsewhere on the board
POS5_PGOOD_OC: U301.25, U301.28, U301.38, U301.49; also elsewhere on the board
POS5_RUN: U301.23, U301.27, U301.51, U301.53; also elsewhere on the board
POS5_SS: U301.22, U301.37, U301.40, U301.57; also elsewhere on the board
POS5_VOSNS: U301.4, U301.6, U301.16, U301.17; also elsewhere on the board
~POS5_THDN: U601.38; also elsewhere on the board

Notes on the sheet:
+5V Phase 3
Route as diff pairs

Schematic: POS5_Phase_4.sch

Parts:
C701, C702, C703, C705, C707, C715: 100uF; CP_Tantalum_Case-B_EIA-3528-21_Reflow; Voltage 6.3V; Tolerance 20%; Digi-Key PN 478-9994-1-ND
C704, C709: 1uF; C_0603; Voltage 16V; Digi-Key PN 1276-6524-1-ND
C706, C708: 0.1uF; C_0603; Voltage 50V; Digi-Key PN 490-4779-1-ND
C710: 0.22uF; C_0402; Voltage 10V; Digi-Key PN 1276-1049-1-ND
C711, C713: 22uF; C_1210; Voltage 25V; Digi-Key PN 445-1436-1-ND
C712, C714: 100uF; C_1210; Voltage 10V; Digi-Key PN 587-3432-1-ND
L701: 0.47uH; L_Vishay_IHLP-4040; Tolerance 20%; Digi-Key PN 541-2595-1-ND
R701, R702: 2; R_0603; Tolerance 1%; Digi-Key PN RMCF0603FT2R00CT-ND
R703: 1.4k; R_0402; Tolerance 1%; Digi-Key PN RMCF0402FT1K40CT-ND
R704, R705: 0; R_0402; Tolerance 1%; Digi-Key PN RMCF0402ZT0R00CT-ND
U301: LTC7851UHH; QFN-58-1EP_9x5mm_Pitch0.4mm; Digi-Key PN LTC7851IUHH#PBF-ND
U701: SiC779; MLP66-40_6x6mm_Pitch0.5mm; Digi-Key PN SIC779CD-T1-GE3CT-ND

Connections:
+5.5V_MNG: C704.1, R701.1, U701.3, U701.39; also elsewhere on the board
+5V: C701.1, C702.1, C703.1, C705.1, C707.1, C712.1, C714.1, C715.1, L701.2, R705.2; also elsewhere on the board
+12V: C709.1, C711.1, C713.1, U701.8, U701.9, U701.10, U701.11, U701.12, U701.13, U701.14, U701.P2; also elsewhere on the board
/POS5 Phase 1/POS5_ISNS1_-: U301.45; also elsewhere on the board
/POS5 Phase 1/POS5_VSNSO1_-: U301.3; also elsewhere on the board
/POS5 Phase 2/POS5_ISNS2_-: U301.44; also elsewhere on the board
/POS5 Phase 3/POS5_ISNS3_-: U301.33; also elsewhere on the board
/POS5 Phase 4/POS5_ISNS4_+: R703.1, R704.1
/POS5 Phase 4/POS5_ISNS4_-: C710.1, R705.1, U301.32
GND: C701.2, C702.2, C703.2, C704.2, C705.2, C706.2, C707.2, C709.2, C711.2, C712.2, C713.2, C714.2, C715.2, U301.5, U301.59, U701.5, U701.16, U701.17, U701.18, U701.19, U701.20, U701.21, U701.22, U701.23, U701.24, U701.25, U701.26, U701.27, U701.28, U701.37, U701.P1; also elsewhere on the board
unnamed 18: U301.39; also elsewhere on the board
unnamed 21: U301.58; also elsewhere on the board
unnamed 25: U301.46; also elsewhere on the board
unnamed 29: U301.43; also elsewhere on the board
unnamed 33: U301.34; also elsewhere on the board
unnamed: C706.1, R701.2, U701.2
unnamed: C708.1, R702.2
unnamed: C708.2, U701.7
unnamed: C710.2, R703.2, U301.31
unnamed 43: U301.54; also elsewhere on the board
unnamed: L701.1, R704.2, U701.15, U701.29, U701.30, U701.31, U701.32, U701.33, U701.34, U701.35, U701.P3
unnamed 70: U301.56; also elsewhere on the board
unnamed 75: U301.2; also elsewhere on the board
unnamed: R702.1, U701.4
unnamed: U301.24, U701.40
unnamed 81: U301.26; also elsewhere on the board
unnamed 82: U301.50; also elsewhere on the board
unnamed 83: U301.52; also elsewhere on the board
POS5_COMP: U301.1, U301.9, U301.13, U301.20; also elsewhere on the board
POS5_EXTVCC: U301.10, U301.11, U301.12, U301.21; also elsewhere on the board
POS5_IAVG: U301.30, U301.35, U301.42, U301.47; also elsewhere on the board
POS5_ILIM: U301.29, U301.36, U301.41, U301.48; also elsewhere on the board
POS5_PGOOD_OC: U301.25, U301.28, U301.38, U301.49; also elsewhere on the board
POS5_RUN: U301.23, U301.27, U301.51, U301.53; also elsewhere on the board
POS5_SS: U301.22, U301.37, U301.40, U301.57; also elsewhere on the board
POS5_VOSNS: U301.4, U301.6, U301.16, U301.17; also elsewhere on the board
~POS5_THDN: U701.38; also elsewhere on the board

Notes on the sheet:
+5V Phase 4
Route as diff pairs

Schematic: POS5P5_MNG.sch

Parts:
C801: 10uF; CP_Tantalum_Case-B_EIA-3528-21_Reflow; Voltage 16V; Tolerance 10%; Digi-Key PN 399-5034-1-ND
C802, C803, C804: 0.1uF; C_0603; Voltage 50V; Digi-Key PN 490-4779-1-ND
C805: 100uF; CP_Tantalum_Case-B_EIA-3528-21_Reflow; Voltage 6.3V; Tolerance 20%; Digi-Key PN 478-9994-1-ND
R801: 200; R_0603; Tolerance 1%; Digi-Key PN MCT0603-200-CFCT-ND
R802: 680; R_0603; Tolerance 1%; Digi-Key PN P680HCT-ND
TP801: TP; Measurement_Point_Round-SMD-Pad_Small
U801: LM1117-ADJ; SOT-223-3_TabPin2; Digi-Key PN LM1117IMPX-ADJ/NOPBCT-ND

Connections:
+5.5V_MNG: C804.1, C805.1, R801.1, TP801.1, U801.2; also elsewhere on the board
+12V: C801.1, C802.1, U801.3; also elsewhere on the board
GND: C801.2, C802.2, C803.2, C804.2, C805.2, R802.2; also elsewhere on the board
unnamed: C803.1, R801.2, R802.1, U801.1

Notes on the sheet:
+5.5V MNG

Schematic: Power_Output.sch

Parts:
J901, J902: +5V OUT; Wuerth_7461096_M4_Shank_9pos; Digi-Key PN 732-3214-ND
J903, J904: GND OUT; Wuerth_7461096_M4_Shank_9pos; Digi-Key PN 732-3214-ND

Connections:
+5V: J901.1, J902.1; also elsewhere on the board
GND: J903.1, J904.1; also elsewhere on the board

Notes on the sheet:
Place bulk output caps close to terminals
Power Output

Schematic: Mechanical.sch

Parts:
MH1001, MH1003, MH1004, MH1006: MountingHole; MountingHole_3mm
MK1001, MK1002, MK1009, MK1010: 4-40 Screw; Digi-Key PN 36-9900-ND
MK1003, MK1004, MK1011, MK1012: 4-40 Standoff; Digi-Key PN 36-8400-ND

Notes on the sheet:
Mounting Holes and Mechanical Components

Schematic: Active_Load_1.sch

Parts:
C1101: 1uF; C_0603; Voltage 16V; Digi-Key PN 1276-6524-1-ND
C1102: 0.1uF; C_0603; Voltage 50V; Digi-Key PN 490-4779-1-ND
C1103: 10uF; CP_Tantalum_Case-B_EIA-3528-21_Reflow; Voltage 16V; Tolerance 10%; Digi-Key PN 399-5034-1-ND
J1101: FG_LOAD; Pin_Header_Straight_1x02_Pitch2.54mm
J1102: ISNS; Pin_Header_Straight_1x02_Pitch2.54mm
Q1101, Q1102: IPC100N04S51R7ATMA1; TDSON-8-1; Digi-Key PN BSC123N10LSGATMA1CT-ND
R1101, R1105, R1106: 10k; R_0603; Tolerance 1%; Digi-Key PN RHM10KADCT-ND
R1102, R1103, R1104: 10; R_0603; Tolerance 1%; Digi-Key PN YAG3351CT-ND
R1107, R1108: 5m; R_2512; Tolerance 1%; Digi-Key PN YAG2145CT-ND
U1101: LT1010DD; DFN-8-1EP_3x3mm_Pitch0.5mm; Digi-Key PN LT1010CDD#PBF-ND

Connections:
+5V: Q1101.5 (D), Q1102.5 (D); also elsewhere on the board
+12V: C1101.1, C1102.1, C1103.1, R1102.1, U1101.1; also elsewhere on the board
GND: C1101.2, C1102.2, C1103.2, J1101.2, J1102.2, R1101.2, R1105.2, R1106.2, R1107.2, R1108.2, U1101.6, U1101.9; also elsewhere on the board
LOAD_GATE: R1103.2, R1104.2, U1101.3; also elsewhere on the board
unnamed: J1101.1, R1101.1, U1101.8
unnamed: J1102.1, Q1101.1 (S), Q1101.2 (S), Q1101.3 (S), R1107.1
unnamed: Q1101.4 (G), R1103.1, R1105.1
unnamed: Q1102.1 (S), Q1102.2 (S), Q1102.3 (S), R1108.1
unnamed: Q1102.4 (G), R1104.1, R1106.1
unnamed: R1102.2, U1101.2

Notes on the sheet:
Active Load Driver and Active Load Bank 1

Schematic: Active_Load_2.sch

Parts:
Q1201, Q1202: IPC100N04S51R7ATMA1; TDSON-8-1; Digi-Key PN BSC123N10LSGATMA1CT-ND
R1201, R1202: 10; R_0603; Tolerance 1%; Digi-Key PN YAG3351CT-ND
R1203, R1204: 10k; R_0603; Tolerance 1%; Digi-Key PN RHM10KADCT-ND
R1205, R1206: 5m; R_2512; Tolerance 1%; Digi-Key PN YAG2145CT-ND

Connections:
+5V: Q1201.5 (D), Q1202.5 (D); also elsewhere on the board
GND: R1203.2, R1204.2, R1205.2, R1206.2; also elsewhere on the board
LOAD_GATE: R1201.2, R1202.2; also elsewhere on the board
unnamed: Q1201.1 (S), Q1201.2 (S), Q1201.3 (S), R1205.1
unnamed: Q1201.4 (G), R1201.1, R1203.1
unnamed: Q1202.1 (S), Q1202.2 (S), Q1202.3 (S), R1206.1
unnamed: Q1202.4 (G), R1202.1, R1204.1

Notes on the sheet:
Active Load Bank 2

Schematic: Active_Load_3.sch

Parts:
Q1301, Q1302: IPC100N04S51R7ATMA1; TDSON-8-1; Digi-Key PN BSC123N10LSGATMA1CT-ND
R1301, R1302: 10; R_0603; Tolerance 1%; Digi-Key PN YAG3351CT-ND
R1303, R1304: 10k; R_0603; Tolerance 1%; Digi-Key PN RHM10KADCT-ND
R1305, R1306: 5m; R_2512; Tolerance 1%; Digi-Key PN YAG2145CT-ND

Connections:
+5V: Q1301.5 (D), Q1302.5 (D); also elsewhere on the board
GND: R1303.2, R1304.2, R1305.2, R1306.2; also elsewhere on the board
LOAD_GATE: R1301.2, R1302.2; also elsewhere on the board
unnamed: Q1301.1 (S), Q1301.2 (S), Q1301.3 (S), R1305.1
unnamed: Q1301.4 (G), R1301.1, R1303.1
unnamed: Q1302.1 (S), Q1302.2 (S), Q1302.3 (S), R1306.1
unnamed: Q1302.4 (G), R1302.1, R1304.1

Notes on the sheet:
Active Load Bank 3

Schematic: Loop_Response.sch

Parts:
J1401: VOUT; Pin_Header_Straight_1x02_Pitch2.54mm
J1402: LOOP_TAP; Pin_Header_Straight_1x02_Pitch2.54mm
J1403: Wave_Gen_In; Pin_Header_Straight_1x02_Pitch2.54mm
T1401: 1:1 Pulse Transformer; Murata_78601_9C; Digi-Key PN 811-2650-ND

Connections:
+5V: J1401.1, T1401.4; also elsewhere on the board
GND: J1401.2, J1402.2, J1403.2, T1401.2; also elsewhere on the board
LOOP_TAP: J1402.1, T1401.3; also elsewhere on the board
unnamed: J1403.1, T1401.1

Notes on the sheet:
Open Loop Transfer Function Test Components

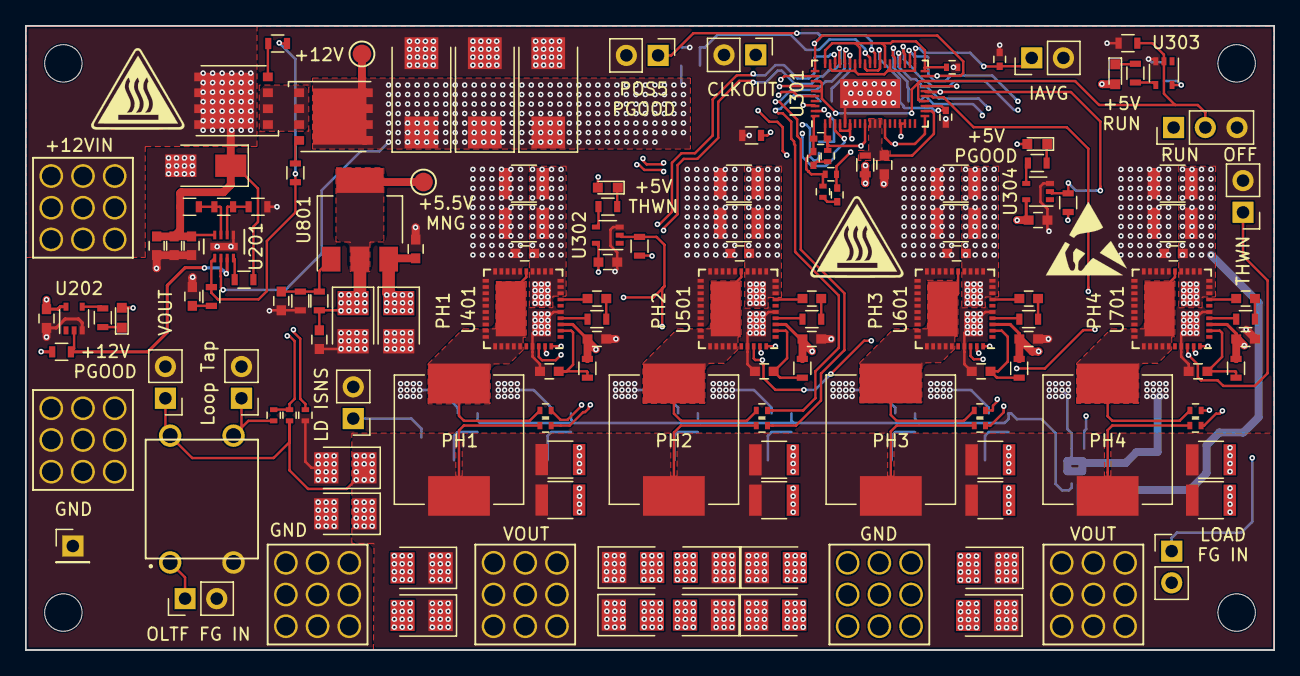
[picture p18: board LTC7851_Demo.kicad_pcb from above]

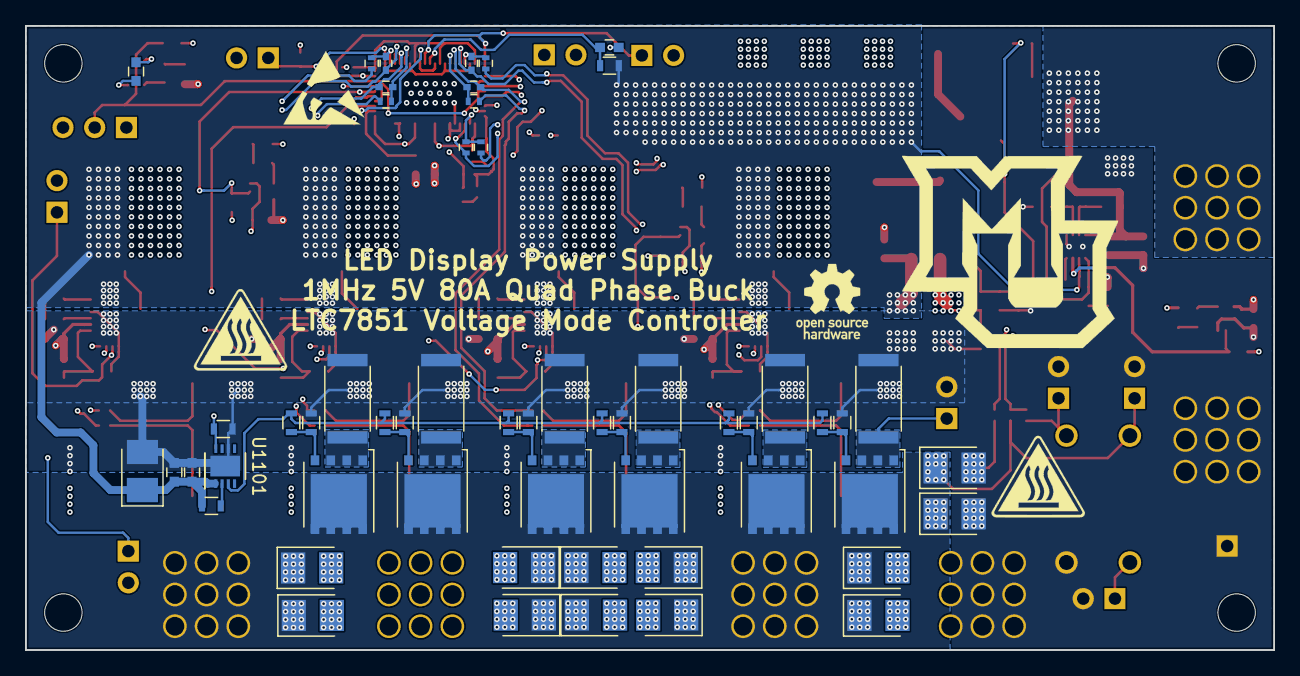
[picture p19: board LTC7851_Demo.kicad_pcb from below]

Board: 4 copper layers, 100.0 x 50.0 mm, 208 parts (55 on the bottom side), 94 nets.
