drewsum/LTC7851_Demo/(commit log)

2018-10-04 Added kicad project
    [LTC7851_Demo.kicad_pcb, LTC7851_Demo.sch]
2018-10-05 Populated Phase 1 page
    [LTC7851_Demo.sch, POS5_Control.sch, POS5_Phase_1.sch, POS5_Phase_2.sch, POS5_Phase_3.sch, POS5_Phase_4.sch, Power_Input.sch]
2018-10-06 Added LDO for VCC input, cleaned some stuff up
    [LTC7851_Demo.sch, Mechanical.sch, POS5_Control.sch, POS5_Phase_1.sch, POS5_Phase_2.sch, POS5_Phase_4.sch, POS5_VCC.sch, Power_Input.sch]
2018-10-10 Added blank active load pages
    [Active_Load_1.sch, Active_Load_2.sch, Active_Load_3.sch, LTC7851_Demo.sch, Mechanical.sch, POS5_Control.sch, POS5_Phase_1.sch, POS5_Phase_2.sch]
2018-10-11 Added active load sheets
    [Active_Load_1.sch, Active_Load_2.sch, Active_Load_3.sch, Active_Load_4.sch, LTC7851_Demo.sch, Loop_Response.sch, Mechanical.sch, POS5_Control.sch]
2018-10-11 Removed extra active load sheet
    [Active_Load_4.sch]
2018-10-12 Added component values for all phase 1 components
    [Active_Load_1.sch, Active_Load_2.sch, Active_Load_3.sch, LTC7851_Demo.sch, Loop_Response.sch, Mechanical.sch, POS5P5_MNG.sch, POS5_Control.sch]
2018-10-13 Duplicated master phase, added status LEDs and a few test points
    [Loop_Response.sch, Mechanical.sch, POS5P5_MNG.sch, POS5_Control.sch, POS5_Phase_1.sch, POS5_Phase_2.sch, POS5_Phase_3.sch, POS5_Phase_4.sch]
2018-10-13 Filled in power input page
    [Active_Load_1.sch, Active_Load_2.sch, Mechanical.sch, Power_Input.sch]
2018-10-14 Assigned some custom footprints
    [Loop_Response.sch, POS5_Control.sch, POS5_Phase_1.sch, POS5_Phase_2.sch, POS5_Phase_3.sch, POS5_Phase_4.sch, Power_Input.sch, Power_Output.sch]
2018-10-14 Annotated schematic
    [Active_Load_1.sch, Active_Load_2.sch, Active_Load_3.sch, Loop_Response.sch, Mechanical.sch, POS5P5_MNG.sch, POS5_Control.sch, POS5_Phase_1.sch]
2018-10-14 Cleaned up for ERC
    [POS5P5_MNG.sch, POS5_Control.sch]
2018-10-14 Changed cap voltage rating
    [Power_Input.sch]
2018-10-14 Added Digi-Key part numbers for all parts
    [Active_Load_1.sch, Active_Load_2.sch, Active_Load_3.sch, POS5P5_MNG.sch, POS5_Control.sch, POS5_Phase_1.sch, POS5_Phase_2.sch, POS5_Phase_3.sch]
2018-10-14 Assigned footprints
    [Active_Load_1.sch, Active_Load_2.sch, Active_Load_3.sch, Loop_Response.sch, Mechanical.sch, POS5P5_MNG.sch, POS5_Control.sch, POS5_Phase_1.sch]
2018-10-14 Added page titles
    [Active_Load_1.sch, Active_Load_2.sch, Active_Load_3.sch, LTC7851_Demo.sch, Loop_Response.sch, POS5P5_MNG.sch, POS5_Control.sch, POS5_Phase_1.sch]
2018-10-14 Added design rules, layer setup
    [LTC7851_Demo.kicad_pcb]
2018-10-14 Board outline, mounting holes placed
    [LTC7851_Demo.kicad_pcb]
2018-10-14 Arranged components for phase 1
    [LTC7851_Demo.kicad_pcb]
2018-10-14 Duplicated phase 1 four times and changed ref des
    [LTC7851_Demo.kicad_pcb]
2018-10-14 Placed phases on board
    [Active_Load_1.sch, Active_Load_2.sch, Active_Load_3.sch, LTC7851_Demo.kicad_pcb]
2018-10-14 Finished arranging parts on board
    [LTC7851_Demo.kicad_pcb, Power_Input.sch]
2018-10-14 Flipped order of phases on PCB
    [LTC7851_Demo.kicad_pcb]
2018-10-14 Flipped phases again, better order now
    [LTC7851_Demo.kicad_pcb]
2018-10-14 Added GND plane
    [LTC7851_Demo.kicad_pcb]
2018-10-14 More routing
    [LTC7851_Demo.kicad_pcb]
2018-10-16 Added KiCad version info to readme.md
2018-10-16 A lot more power flooding
    [LTC7851_Demo.kicad_pcb, Mechanical.sch]
2018-10-16 revising power vias
    [LTC7851_Demo.kicad_pcb]
2018-10-17 Routed current sense and voltage sense
    [LTC7851_Demo.kicad_pcb]
2018-10-17 Routed PWM
    [LTC7851_Demo.kicad_pcb]
2018-10-17 Routed some garbage near the controller
    [LTC7851_Demo.kicad_pcb]
2018-10-17 More routing, removed GL ang GH phase test points
    [LTC7851_Demo.kicad_pcb, POS5_Phase_1.sch, POS5_Phase_2.sch, POS5_Phase_3.sch, POS5_Phase_4.sch]
2018-10-17 Resolved mounting hole ref des issue
    [LTC7851_Demo.kicad_pcb, Mechanical.sch]
2018-10-17 More routing, silkscreen labels
    [LTC7851_Demo.kicad_pcb]
2018-10-18 Finished ROUTING (for the most part)
    [LTC7851_Demo.kicad_pcb, POS5_Control.sch, POS5_Phase_1.sch, POS5_Phase_2.sch, POS5_Phase_3.sch, POS5_Phase_4.sch]
2018-10-18 Finished routing, added 3D render png, ordered PCB
    [LTC7851_Demo.kicad_pcb, LTC7851_Demo_BOM.xlsx]
2018-10-25 Added a few connectors and cleaned up some routing
    [Active_Load_1.sch, Active_Load_2.sch, Active_Load_3.sch, LTC7851_Demo.kicad_pcb, POS5_Control.sch, POS5_Phase_1.sch, POS5_Phase_2.sch, POS5_Phase_3.sch]
2018-10-31 Substantial wiring and layout changes
    [LTC7851_Demo.kicad_pcb, LTC7851_Demo_BOM.xlsx, LTC7851_Demo_bom_.xlsx, Loop_Response.sch, POS5_Phase_1.sch, POS5_Phase_2.sch, POS5_Phase_3.sch, POS5_Phase_4.sch]
2018-11-01 Furthe rrouting refinements
    [LTC7851_Demo.kicad_pcb]
2018-11-03 Finished routing and added 3D renders
    [LTC7851_Demo.kicad_pcb]
